Mrrvm/SCDTR/relatório.pdf

Controlo de Iluminaçao Distribu ˜ | ído

Sistemas de Controlo Distribuído em Tempo Real (MEEC) - Grupo 5 Carlos Aleluia, 81038 — Filipe Madeira, 81076 — Mariana Martins, 80856

Projeto disponível em https://github.com/Mrrvm/SCDTR
Link para vídeo de funcionamento do sistema presente no GitHub

10 de janeiro, 2018

Resumo—Dado um sistema de iluminaçao, o objetivo deste ˜
projeto e control ´ | a-lo distribuidamente de forma a maximizar o ´
conforto do utilizador e a minimizar a energia gasta. Propomos
a utilizaçao do algoritmo ˜ | | consensus aplicado a um sistema de
controlo, em que uma rede de agentes chega a um consenso da
soluçaõ otima, que gera a refer ´ | encia do sistema, ou determina ˆ
que nao existe uma soluç ˜ | ao vi ˜ | avel. Definimos como a rede dis- ´
tribuída de agentes aplica o algoritmo e construímos meios para testar a sua eficiencia. Obtivemos um sistema como pretendido ˆ inicialmente.
Palavras-Chave: Consensus, PID, servidor TCP/IP, I2C sniffing, Controlo distribuído.
I. INTRODUÇ AÕ
A ultima d ´ | ecada trouxe um nova forma de iluminaç ´ | ao: ˜
LEDs (Light Emitting Diodes). Comparativamente a l ` ampada ˆ incadescente convencional, o LED dura cerca de 50 vezes mais
horas e usa muito menos potencia [1]. A l ˆ | ampada fluorescente ˆ
foi um avanço relativamente a anterior, mas o LED continua a `
ter mais duraçao e efici ˜ | encia, e n ˆ | ao tem os perigos associados ˜
ao mercurio [2], apesar de ter perigos associados a outros ´
metais. Permite, tambem, uma integraç ´ | ao mais f ˜ | acil com ´
computadores e sensores. No entanto, esta tecnologia carece de optimizaçao em termos de energia e conforto do utilizador. ˜ De acordo com o tipo de ambiente, com a iluminaçao externa ˜
existente e com a ocupaçao, deveria ser poss ˜ | ível definir a
luminosidade, frequencia e c ˆ | or dos LEDs que comp ˆ | oem o ˜
sistema de iluminaçao. Para que isto seja faz ˜ | ível, este sistema
tem de ser definido como uma rede de agentes, em que cada agente tenta manter as características desejadas no seu LED, e podem comunicar entre si de modo a estabelecer o que e o ´ melhor para todos.
Esta rede tanto poderia ser distribuída como centralizada, naõ
obstante a versao distribu ˜ | ída apresenta alguns benefícios que
tornam a soluçao mais facilmente escal ˜ | avel. Ao p ´ | or o sistema ˆ
embebido mais perto do ponto de atuaçao, os tempos de ˜
resposta sao mais curtos, dado que um controlador central n ˜ | aõ
tem de lidar com operaçoes pequenas. N ˜ | aõ e necess ´ | ario fazer ´
ligaçoes com o n ˜ | o central, que teria uma procura cont ´ | ínua por
mais poder computacional, logo os custos de hardware saõ tambem mais baixos. ´
Este problema esta atualmente a ser investigado [3], [4], [5], e ´
que algumas soluçoes baseiam-se no uso do algoritmo ˜ | simplex,
que resolve problemas lineares e por si so n ´ aõ e distribu ´ | ído.
E neste contexto que propomos um sistema de controlo ´ distribuído de forma coordenada por uma rede de agentes baseado no algoritmo consensus [6], que e monitorizado com ´
estatísticas por clientes atraves de um servidor que as l ´ | e da ˆ
rede. Para testar a nossa soluçao, estabelecemos a configuraç ˜ | aõ
apresentada na proxima secç ´ | ao. Todo o c ˜ | odigo do projeto est ´ | á
disponível no repositorio de ´ | github indicado acima.

II. CONFIGURAÇ AO DO SISTEMA ˜

O modelo em causa pretende simular uma sala com duas lu-
minarias. Cada lumin ´ | aria tem um sensor, um microcontrolador ´
(arduino UNO) e um LED. Todos os elementos se encontram inseridos dentro de uma caixa como se pode observar na figura
1. A caixa foi forrada a branco de maneira a refletir mais a luz, assim como os arduinos. As ligaçoes foram feitas numa ˜
placa breadboard, que esta colada ao ch ´ | ao da caixa. Na caixa ˜
existe tambem um motor servo e uma janela. O servo pode ser ´ acionado por um dos arduinos, de maneira a abrir a janela. Por fora, a caixa incluí um Raspberry Pi 3B usado como servidor como se observa na figura 2.

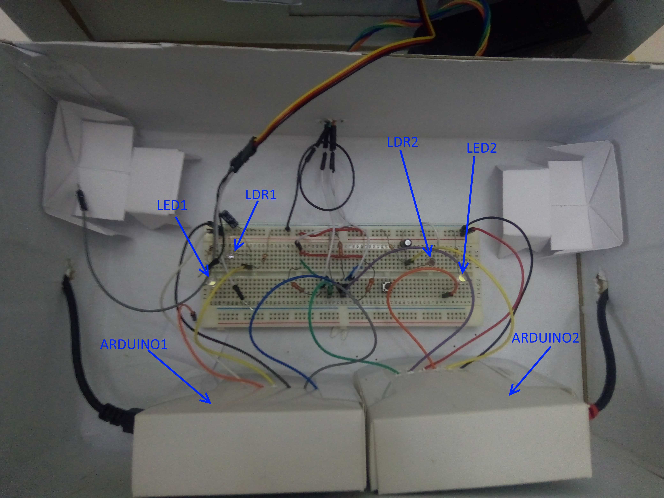
[picture p2: figure]

Figura 1: Caixa com luminarias. ´

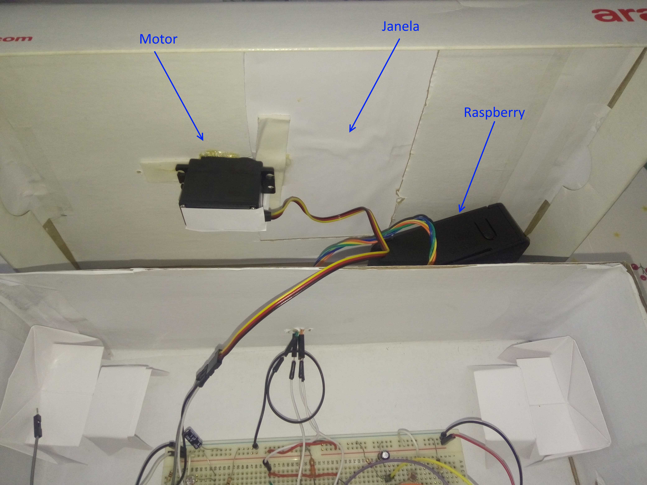
[picture p3: figure]

Figura 2: Motor, janela e raspberry.

III. ABORDAGEM

A. Calibraçao do LDR ˜
O sensor de luz utilizado e um LDR ( ´ | Light Dependent
Resistor). A resistencia diminui quanto maior for a intensidade ˆ de luz incidente. O sensor foi implementado de acordo com
a figura 3. Com mais outra resistencia ˆ | e poss ´ | ível obter um
divisor de tensao. Esta ˜ | e depois lida pelo o ardu ´ | íno e analisada.
A tensao lida ˜ | e dada pela express ´ | ao 1. O condensador permite ˜
a reduçao do ru ˜ | ído captado pelo sensor.

U = 5

R1
R1 + R2

(1)

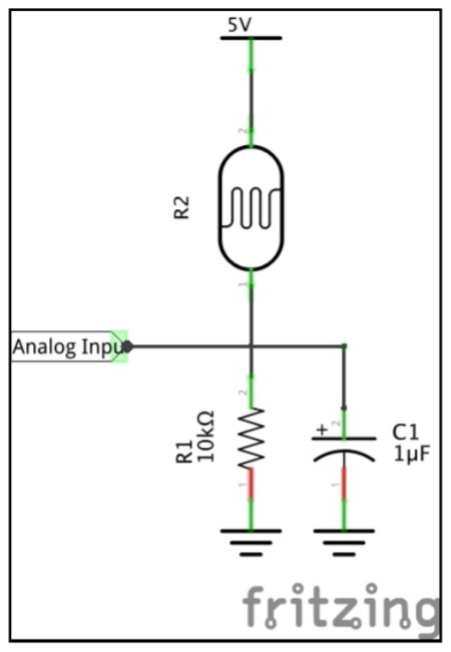
[picture p4: figure]

Figura 3: Circuito sensor de iluminaçao. ˜

E necess ´ | ario calibrar este sensor, pois existe uma gama de ´
possíveis valores, como se pode observar na figura 4, com os quais se pode definir uma reta que indica o valor da resistencia ˆ
em funçao da iluminaç ˜ | ao. Para descobrir os par ˜ | ametros da ˆ
reta foi usado um outro medidor de lux, onde se mediu a
iluminaçao e de seguida com base nas equaç ˜ | oes da matriz em ˜
baixo calculou-se os parametros A e B, sendo o declive e a ˆ ordenada na origem respetivamente.
| log10 ∗ R1 log10 ∗ R2
=
log10L1 | 1
log10L2 | 1

A
B

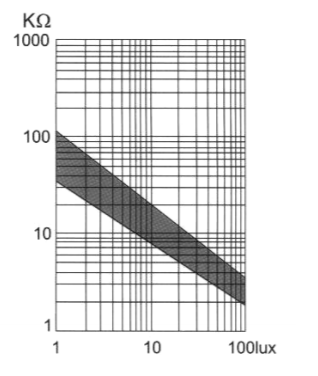
[picture p5: figure]

Figura 4: Resistencia em funç ˆ | ao iluminaç ˜ | ao. ˜
B. Identificaçao individual do sistema ˜
O sensor deteta a intensidade de lux atual e envia a
informaçao para o ardu ˜ | íno. De seguida o arduíno ajusta a
intensidade do LED de acordo com os requisitos impostos
ao sistema. O ajuste e feito atrav ´ | es de PWM ( ´ | Pulse Width
Modulation) e depende dos seguintes fatores:
- Luminosidade mínima com luminaria desocupada (25 ´ lux);
- Luminosidade mínima com luminaria ocupada (50 lux); ´
- Intensidade de luz vinda do exterior;
- Intensidade de luz proveniente de outros LEDs.

O PWM varia entre 0 e 255 o que e equivalente a 0V e ´
5V em tensao cont ˜ | ínua, mas e preciso saber a quantos lux ´
equivale cada valor de PWM. Sabendo que a intensidade de luz varia linearmente com o PWM, determinou-se o ganho (declive da reta) que define essa funçao. Na figura 5 pode-se ˜
observar os lux em funçao do PWM e constatar que a variaç ˜ | | aõ
e aproximadamente linear com um ganho de 0,3346. ´

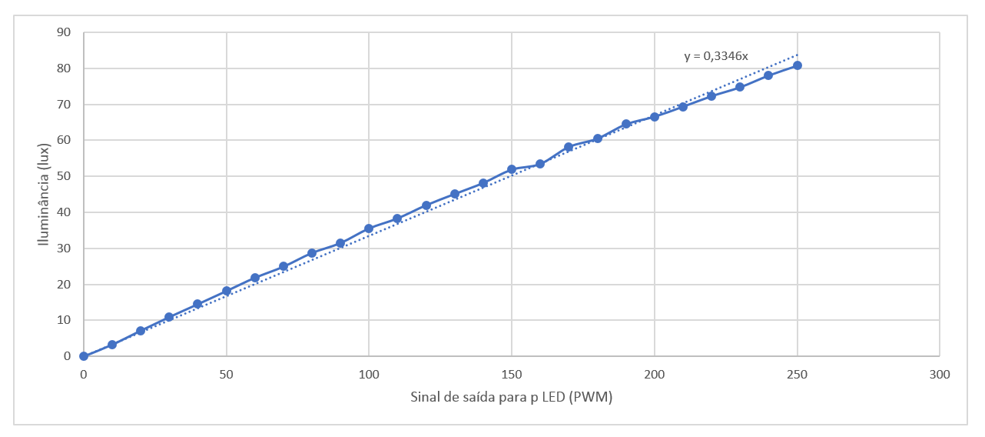
[picture p6: figure]

Figura 5: Lux em funçao do PWM. ˜

De modo a converter o valor de PWM para lux chegou-
se a equaç ` | ao final 2. O VDD ˜ | e igual ao valor de 5V, PWM ´
representa o valor que se quer converter e os parametros A e ˆ B representam a reta do LDR.

(

V DD
PWM
| | − 1) ∗ R1
| | 10B

1
A

(2)

O sistema de controlo implementado esta traduzindo na ´
figura 6, sendo que tanto o valor de referencia como o ˆ | feedback
sao controlados pelo ardu ˜ | íno. Estes topicos ser ´ | ao falados mais ˜
a frente. O ` | feedback e essencial, pois garante que a luz ´
proveniente do LED naõ e excessiva, diminuindo os consumos ´ de energia e tambem porque permite que o sistema se adapte a ´
uma nova situaçao de uma maneira mais confort ˜ | avel, ou seja, ´
com transiçoes menos bruscas. ˜

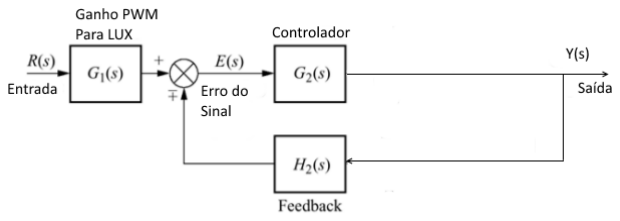
[picture p7: figure]

Figura 6: Esquema do controlador da luminaria. ´

Um ponto importante para o bom funcionamento do sistema
e a frequ ´ | encia de funcionamento, ou seja, a frequ ˆ | encia de ˆ
amostragem. O sistema tem que garantir a oscilaçao do LED ˜
naõ e detet ´ | avel pelo olho humano, logo tem de ser inferior a ´
40ms. No entanto nao faz sentido a frequ ˜ | encia ser o mais baixo ˆ
possível, pois implica um maior gasto de energia. Existe ainda um problema aderente ao condensador existente no circuito do sensor. O condensador requer um determinado tempo a carregar e portanto existe uma constante de tempo associada. De forma a medir esta constante foram retiradas amostras com o PWM a aumentar e obteve-se o grafico da figura 7. O PMW ´ foi aumentado apenas de meio em meio segundo de maneira
a que tensao lida tivesse tempo de ficar est ˜ | avel. ´

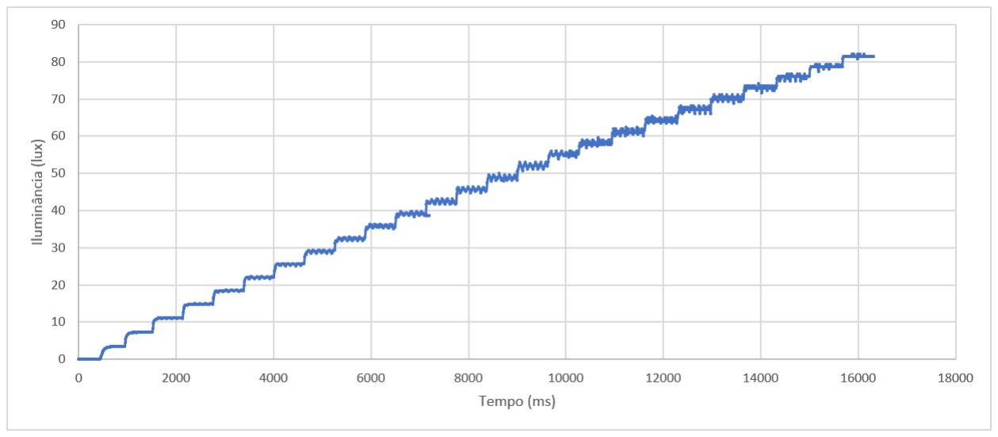
[picture p8: figure]

Figura 7: Lux em funçao do tempo. ˜

Como era de esperar o condensador demora mais tempo a carregar (a chegar um valor de tensao constante) quando ˜ o PWM se encontra inicialmente a 0. Isto porque nao s ˜ ó o condensador encontra-se completamente descarregado, mas
tambem porque a constante ´ | e dada pela formula 3 e esta ´
depende de R2, sendo que e maior quanto menor for a ´ intensidade de luz, como e o caso. ´
τ = R2C1 | (3)

Na figura 8 pode-se observar com mais pormenor a constante de tempo para o pior caso descrito em cima. A constante de tempo e determinada pelo o tempo que demora a atingir ´
√

1/2= 70% do valor em regime constante. Neste caso o valor obtido foi de 81ms. Este e um valor bastante alto, no entanto ´

e um caso particular, que s ´ | o acontece uma vez e n ´ | ao tem ˜
influencia no sistema. Verificou-se que para mudanças de va- ˆ lores típicos, como por exemplo de 25 lux para 50, a constante e de 8 ´ ms. Como tal optou-se por escolher uma frequencia de ˆ funcionamento tendo em conta a sensibilidade do olho humano e uma margem de segurança. O valor escolhido foi de 30ms.

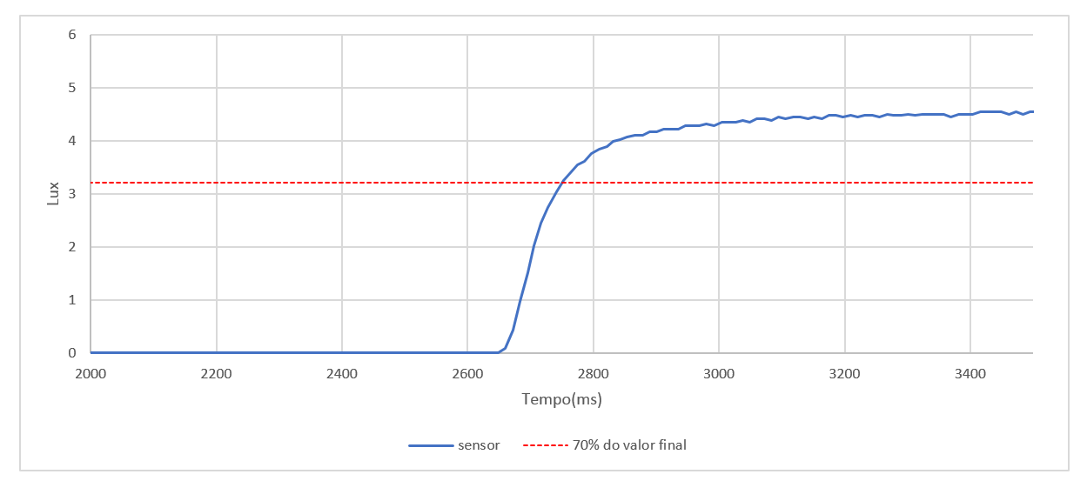
[picture p9: figure]

Figura 8: Lux em funçao do tempo para o pior caso. ˜

Com a constante de tempo e o ganho obtidos, o sistema individual em ciclo aberto e dado por ´

K0
1 + τ

C. Identificaçao do sistema com m ˜ | ultiplos ardu ´ | ínos
A rede de agentes e o aglomerado de v ´ | | arios sistemas ´
individuais descritos anteriormente, sendo que os ganhos relativos de cada um nao se alteram. No entanto, passam a ˜ existir ganhos entre eles, porque o LED de uma luminaria ´ pode ter influencia na intensidade de luz recebida por outra. ˆ
N luminarias implicam a exist ´ | encia de uma matriz de ganhos ˆ
com dimensao N x N, que neste caso ˜ | e de 2 x 2. ´
Y11

Y22
=
K11 | K12
K21 | K22 X11

X22

Na matriz Y e o valor de sa ´ | ída, K e o ganho de uma ´
luminaria em relaç ´ | ao a outra e X ˜ | e a luminosidade de uma ´
mesma luminaria. ´
D. Controlador
O controlador e respons ´ | avel por garantir que a intensidade ´
de luz numa dada luminaria se mant ´ | em dentro dos par ´ | ametros ˆ
estabelecidos. E constitu ´ | ído por 2 componentes: feedfoward
e feedback. Este ultimo tem uma componente proporcional ´ e uma componente integral. Cada arduino equivale a um
controlador local e a unica informaç ´ | ao que tem sobre os ˜
outros arduinos, caso existam, e o ganho de cada arduino ´ relativamente a si proprio, ou seja, a matriz discutida na ´ secçao III-C. ˜

Na figura 9 pode-se observar, mais detalhadamente o sistema de controlo. Todas as componentes irao ser explicadas ˜ de seguida. A componente derivativa foi retirada, pois nao s ˜ ó impedia que o PID funcionasse em tempo real, mas tambem´ porque para este caso, esta componente nao tem qualquer ˜ efeito.
Para minimizar o flickering, na mediçao do erro face ˜ | à
referencia do controlador implementou-se uma ˆ | dead zone, ou

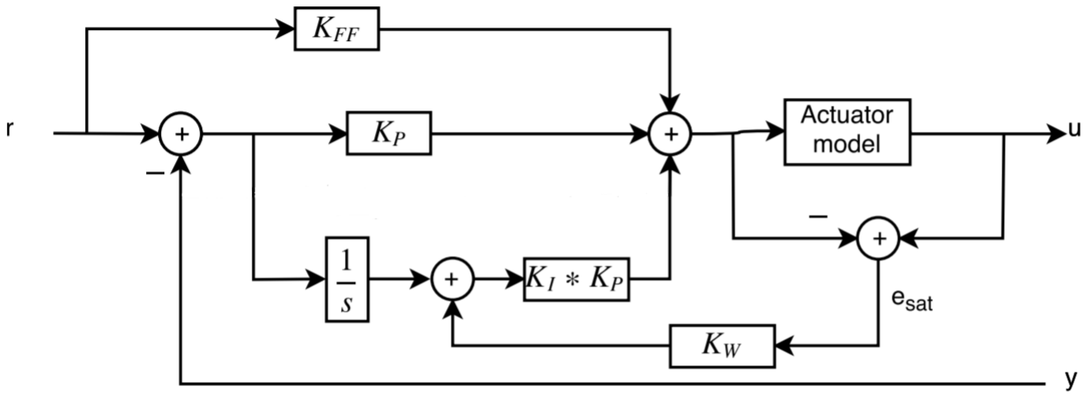
[picture p10: figure]

Figura 9: PID.

seja, o erro medido apenas era considerado caso fosse superior
a um patamar, em modulo. Uma representaç ´ | ao gr ˜ | afica da ´ | dead
zone implementada pode ser vista na figura 10, com parametro ˆ ERROR MAX=1.

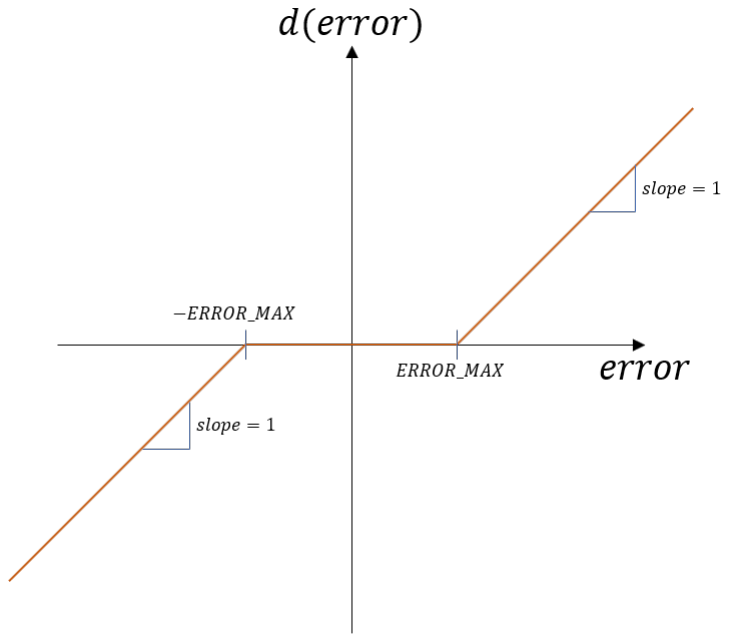
[picture p11: figure]

Figura 10: Deadzone implementada: erro fornecido ao PID
(d(error)) em funçao do erro medido ( ˜ | | error).
1) Feedfoward: Consiste em enviar um sinal de controlo do arduíno para o LED, de modo a acender o LED com uma certa intensidade de luz. Neste caso o controlo e feito com PWM. ´ O feedfoward permite ter uma melhor precisao, assim como ˜ uma melhor estabilidade do sistema e permite ainda atingir o
valor de referencia mais rapidamente. ˆ | E controlado atrav ´ | es da ´
constante KF F equivale ao ganho K medido anteriormente.
2) Feedback: Componente proporcional: Produz um sinal
de saída que e proporcional ´ | a amplitude do erro e(t), sendo `
Kp a constante de proporcionalidade. Este metodo possui a ´
vantagem de eliminar as oscilaçoes do sinal de sa ˜ | ída.
3) Feedback: Componente integral: Produz um sinal de
saída que e proporcional ´ | a magnitude e ` | a duraç ` | ao do erro, ˜
ou seja, ao erro acumulado. Isso fornece uma alternativa para corrigir o erro de offset gerado pela açao proporcional e ˜ acelera a resposta do sistema, permitindo-o chegar ao valor de referencia mais rapidamente. ˆ
Contudo, o termo integral tambem pode levar muitas vezes a ´ instabilidade ou a problemas de windup. O windup consiste
na acumulaçao de erros muito elevado (devido a saturaç ˜ | aõ
de actuadores, por exemplo), e caso ocorra leva a atrasos na resposta ou a overshooting. No caso deste projeto, se a
iluminaçao externa for maior do que a iluminaç ˜ | ao m ˜ | ínima

pretendida e caso esta seja a referencia dada ao PID, como ˆ
o sistema nao consegue retirar luminosidade (saturaç ˜ | ao dos ˜
atuadores), entao o termo integral vai acumular erros negativos ˜
durante um largo período. Se, nestas condiçoes, a iluminaç ˜ | aõ
externa voltar a diminuir, como o termo integral do feedback é
tao negativa o sistema vai permanecer apagado at ˜ | e descarregar ´
o erro acumulado. Um raciocínio semelhante podia ser feito para o caso inverso, levando a overshooting.
Portanto, implementou-se uma medida de anti-windup: em cada ciclo de controlo, se o termo integral for superior a uma
constante W ou inferior a −W, entao este ˜ | e saturado, ou seja, ´
o modulo do termo integral ´ | e sempre mantido no intervalo ´
[−W, W].
Existem diferentes formas de associar o feedforward e o feedback no sistema. Neste projeto, foi utilizada a tecnica de ´ decoupled feedforward, que consiste em utilizar o feedfoward para obter a resposta pretendida em condiçoes ideais e o ˜
feedback apenas ter interferencia para rejeitar perturbaç ˆ | oes ˜
ou nao idealidades do sistema. Para isso, ˜ | e necess ´ | ario um ´
conhecimento mais profundo e uma boa modelizaçao do sis- ˜
tema, pois consiste em fornecer como referencia ao ˆ | feedback
o comportamento esperado do sistema quando fornecido o feedforward.
No nosso caso, em boa aproximaçao (como ali ˜ | as foi visto ´
na secçao III-B), a resposta do sistema ao ˜ | feedforward pode
ser modelada por um escalao de amplitude correspondente ˜
a iluminaç ` | ao de refer ˜ | encia pretendida com um atraso de ˆ
um intervalo de sampling. Portanto, num primeiro ciclo de
controlo apos a alteraç ´ | ao de refer ˜ | encia (e, portanto, de valor ˆ
de feedforward) o termo de feedback fornecido ao sistema e nulo; nos ciclos seguintes, tudo se desenrola normalmente, ´
com referencia igual ao valor que se pretende que a lumin ˆ | aria ´
imponha atraves do LED. ´
E. Calibraçao do sistema ˜
Como foi referido na secçao III-C, numa rede de v ˜ | arios ´
arduinos existem efeitos de acoplamento, traduzidos em primeira ordem por ganhos Kij . Como qualquer alteraçao de ˜
iluminaçao externa ou de organizaç ˜ | | ao no interior da caixa ˜
usada implica mudanças nesses ganhos, era fundamental a
existencia de um m ˆ | etodo de calibraç ´ | ao em cada inicializaç ˜ | aõ
do sistema (ou reinicializaçao, mediante a ordem do cliente). ˜ Portanto, cada vez que o sistema e iniciado ou reiniciado, ´ todos os arduinos na rede iniciam um protocolo que permite cada um deles armazenar um array de ganhos relativos a todos os outros arduinos. Este protocolo consiste num ciclo em que, um arduino de cada vez, percorre todos os valores de duty
cycle (0-255) e todos os outros (incluindo o proprio que est ´ | á
a acender) medem a iluminaçao no seu LDR. Os ganhos s ˜ | aõ
entao calculados linearizando a curva: ˜

Kij =

li
dj
, | (4)
em que li e a iluminaç ´ | ao medida na lumin ˜ | aria ´ | i e dj o duty
cycle imposto na luminaria ´ | j. No final de serem percorridos
todos os valores de dj , toma-se como ganho a media dos ´ declives.

Para minimizar erros aleatorios, permitiu-se ainda definir ´
uma variavel ´ | C que indica o numero de amostras que ser ´ | aõ
retiradas (ou seja, cada arduino percorre todos os duty cycle de 0-255 C vezes).
O processo de troca de informaçao entre os arduinos (envio ˜ do duty cycle imposto de cada vez pelo arduino a acender
o LED) sera explicado mais detalhadamente na secç ´ | ao III-G, ˜
e todo o processo de calibraçao em termos de ˜ | software será
descrito na secçao III-H. ˜
F. Controlo Distribuído e Otimizaçaõ
Quando existem varios controladores em jogo, h ´ | a v ´ arias ´
topologias distintas de como organizar o controlo distribuído, mais concretamente, a capacidade de tomada de decisoes ou ˜ a forma como se comportam para atingir os seus objetivos. No caso específico deste projeto, a topologia utilizada foi de controlo distribuído descentralizado, pois nao existia nenhum ˜ controlador central que toma todas as decisoes globais, mas ˜ sim varios controladores capazes de comunicar entre si as suas ´ decisoes. ˜
Quanto a cooperaç ` | ao ou n ˜ | ao entre os diferentes n ˜ | os, ´ | é
possível o sistema funcionar das duas formas. Para agir de forma nao cooperativa, basta colocar os controladores indivi- ˜
duais a operar segundo a descriçao feita na secç ˜ | ao III-D1: cada ˜
arduino coloca o duty-cycle necessario para atingir a lumino- ´ sidade mínima estabelecida, ignorando a existencia do outro ˆ arduino. Nesta forma de atuar, cada agente apenas se preocupa
em cumprir o seu proprio objetivo, e trata qualquer aç ´ | ao de ˜
um outro agente como perturbaçoes externas e desconhecidas. ˜
Para funcionar de forma cooperativa, e necess ´ | ario um pro- ´
cedimento mais complicado, em que se procede a otimizaç ` | aõ
de uma funçao de custo tendo em conta todas as vari ˜ | | | aveis, ´
por exemplo, efeitos de coupling entre os dois controladores. Assim sendo, e fundamental que tenham um sistema de ´
coordenaçao e comunicaç ˜ | ao eficaz para que cheguem a um ˜
consenso acerca das variaveis que cada um tem que manipular, ´ a fim de atingirem a soluçaõ otima global. ´
Como foi referido nos objetivos do projeto, pretende-se minimizar o consumo de energia, maximizando o conforto de utilizadores (mantendo a iluminaçao acima de certos limites e ˜ reduzindo o flicker ao mínimo possível). Portanto, a funçao de ˜ custo que se pretende minimizar vai ter dois termos: um relacionado com o consumo de energia, ou seja, com dependencia ˆ linear nos duty cycle impressos pelos controladores; e outro
termo quadratico nos ´ | d, que representa um custo adicional
por desgaste da lampada, isto ˆ | e, ao penalizar soluç ´ | oes com ˜
duty cycle perto do maximo, aumenta a longevidade do LED. ´ Na verdade, o problema de otimizaçao pode ser formulado da ˜ seguinte forma:
minimize | c | T d + d T Qd
d1, ..., dN
subject to Kd + o ≥ L,
0 ≤ di ≤ 255, i = 1, ..., N.
| | | | (5)
Como e poss ´ | ível observar, a funçao de custo tem os dois ˜
termos mencionados, cuja influencia relativa ˆ | e determinada ´
pelos coeficientes ci (termo linear) e Qii (termo quadratico). ´
Nota-se que a matriz Q e diagonal pois n ´ | ao faz sentido ˜
a existencia de termos quadr ˆ | aticos cruzados. J ´ | a acerca das ´
restriçoes, a primeira garante que a iluminaç ˜ | ao imposta pelo ˜
conjunto de todos os arduinos (PN
j=1 Kijdj ), acrescentada à
iluminaçao externa existente ( ˜ | oi), e superior ao limite m ´ | ínimo
(Li). A segunda restriçao imp ˜ | oe os limites f ˜ | ísicos aos duty
cycle impostos. Imaginando o caso N = 2, uma forma facil de ´
entender as restriçoes relacionadas com a iluminaç ˜ | ao m ˜ | ínima
e escrev ´ | e-las na forma: ˆ | K11d1 + K12d2 ≥ L1 − o1 ↔ d2 ≥
L1−o1

K12

−

K11
K12
d1, e o mesmo para a restriçao de iluminaç ˜ | aõ
mínima no segundo controlador. Na figura 11 esta representada ´
a regiao delimitada pelas restriç ˜ | oes para o caso ˜ | N = 2. Uma
forma grafica de entender ao que corresponde o m ´ | ínimo que
se procura pode ser visualizada na figura 12.

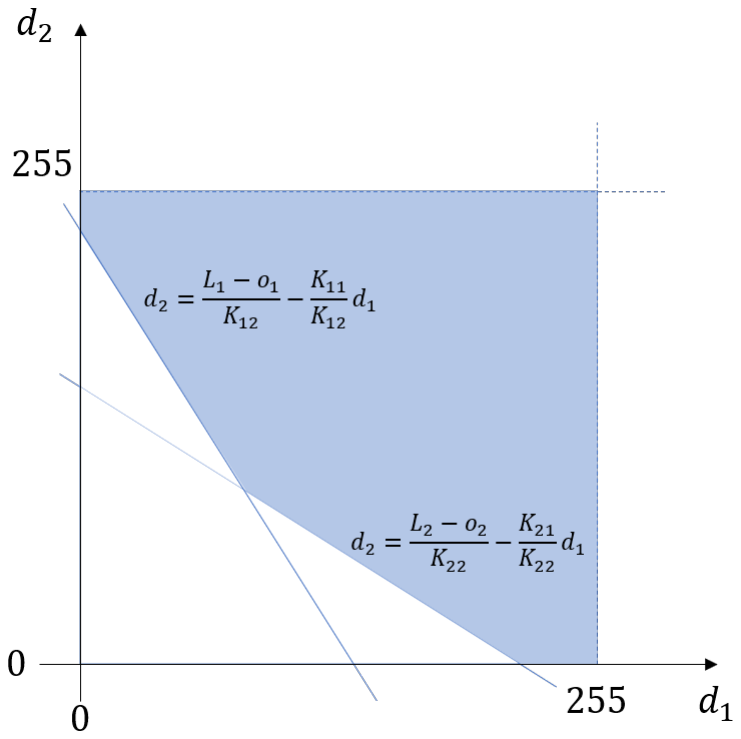
[picture p12: figure]

Figura 11: Representaçao, para o caso ˜ | N = 2, da regiao delimitada ˜
pelas restriçoes. ˜

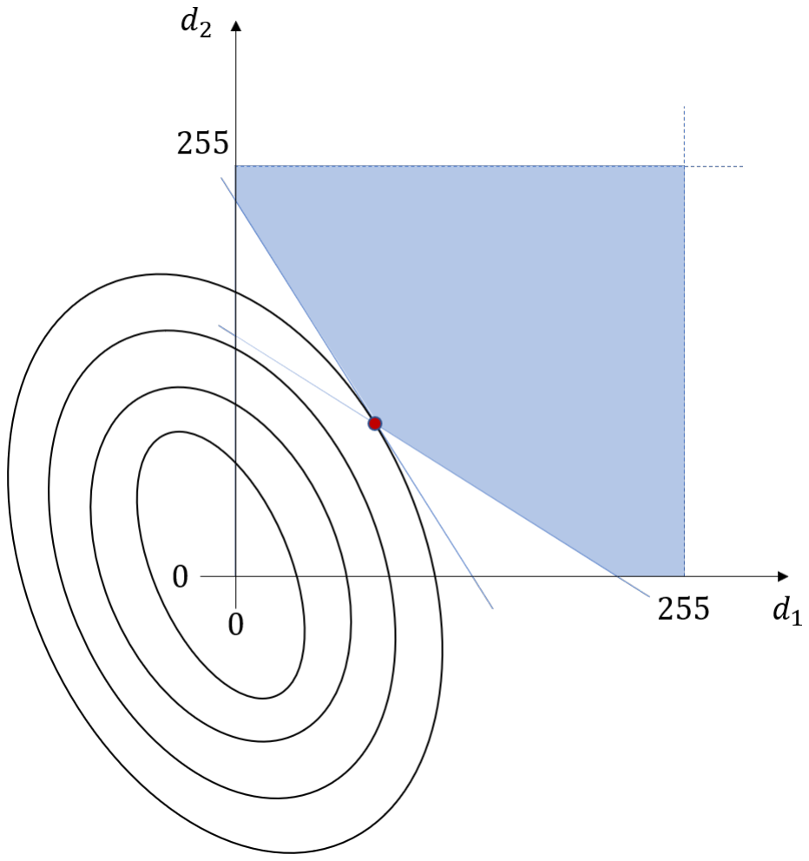
[picture p13: figure]

Figura 12: Representaçao, para o caso ˜ | N = 2, do mínimo da funçaõ
de custo, sujeita as restriç ` | oes. ˜

O problema descrito e um problema quadr ´ | atico, de ´
resoluçao f ˜ | acil caso o problema fosse resolvido por um pro- ´
cessador central com informaçoes de todos os n ˜ | os. Contudo, ´
como neste caso se pretende uma soluçao distribu ˜ | ída, cada
controlador deve calcular a sua variavel de controlo de forma a ´ minimizar a funçao de custo global, desconhecendo, na sua to- ˜ talidade, a informaçao dos outros controladores. Dependendo ˜
de algumas propriedades da funçao de custo e das restriç ˜ | oes, ˜
esta distribuiçao pode ser mesmo imposs ˜ | ível. No entanto, para
o problema em estudo, uma vez que a funçao a minimizar ˜ | é
totalmente separavel e as restriç ´ | oes podem ser parcialmente ˜
decompostas, isto e, o problema pode ser reescrito na forma: ´ minimize PN
i=1 f(di)
d1, ..., dN
subject to PN
i=1 h(di) ≤ 0,
di ∈ Ωi
, i = 1, ..., N,

(6)

existem metodos capazes de resolver problemas de otimizaç ´ | aõ
distribuídos como este. Neste projeto, foi utilizado o metodo ´ de alternating direction method of multipliers, ADMM, uma
ferramenta para resolver problemas de otimizaçao distribu ˜ | ídos
e que podem ser decompostos ate certo ponto, como o presente ´ [6]. Mais concretamente, vai ser aplicado a um problema de
otimizaçao de ˜ | consensus, isto e, onde existem vari ´ | aveis globais ´
- variaveis partilhadas por todos os n ´ | os - que devem refletir ´
as variaveis presentes em cada um dos controladores. No caso ´
apresentado, estas variaveis globais v ´ | ao ser os valores m ˜ | edios ´
de cada di entre todos os nos. Resumindo, o algoritmo vai ´
impor a restriç ˆ | ao de que, em cada controlador, as c ˜ | opias do ´
d sejam iguais ao valor medio que ´ | e partilhado por todos, ´
ou seja, que sejam iguais entre si! Desta forma, cada um
pode proceder a otimizaç ` | ao com restriç ˜ | oes, envolvendo os ˜ | duty
cycle dos outros, sabendo que todos possuem o mesmo valor. [7]
O metodo utilizado ´ | e, ent ´ | ao, um m ˜ | etodo iterativo, em que ´
a condiçaõ di − ¯di = 0, onde ¯di e a m ´ | edia sobre todos os ´
nos de ´ | di
, e satisfeita utilizando penalizaç ´ | oes de Lagrangiano ˜
aumentado, e em que cada iteraçaõ e atualizada a vari ´ | avel dual ´
(multiplicadores de Lagrange), de acordo com o dual ascent method [7]. Ou seja, em cada nó i sao feitas as seguintes ˜
operaçoes, na iteraç ˜ | aõ t:

di = arg min(
1/2 d

T
i Qdi + c

T
i di + y

T
i

(di − d¯i) + ρ
2

||(di − d¯i)||²
2

)
di ∈ χi
d¯i

t+1
=

1
N

PN
j=1 d

t+1
j
y

t+1
i = y

t
i + ρ(d

t+1

i − d¯i

t+1),
(7)
com yi sendo os multiplicadores de Lagrange e ρ o parametro ˆ de penalizaçao de Lagrangiano aumentado. Nota-se que os ˜
índices t nao foram colocados na primeira equaç ˜ | ao para ˜
nao sobrecarregar a notaç ˜ | ao, mas naturalmente ˜ | e calculado ´
o di utilizando os parametros da iterada anterior. Como a ˆ
otimizaçaõ e distribu ´ | ída, os parametros da funç ˆ | ao de custo ape- ˜
nas consideram o efeito do no atual, ou seja, ´ | c
| | T i = [0···ci
···0]
e Q = diag(0 · · · qi
- · · 0), e as restriçoes s ˜ | ao locais: ˜
χi = {di ∈ R | N : 0 ≤ dii ≤ 255 ,

X

N

j=1

Kijdij ≥ Li−oi}. (8)

Ja relativamente ´ | a resoluç ` | ao do problema com restriç ˜ | ao em ˜
cada no, mostra-se facilmente que se reduz a (refer ´ | encia!!): ˆ

d

t+1
i = argmin(
1/2 d

T
i Ridi − d

T
i

zi),
| | di ∈ χi

(9)

em que Ri = Qi + ρI e zi = −ci − yi + ρd¯
i. Portanto,
trata-se de um problema de otimizaçao convexo. A soluç ˜ | aõ
pode estar no interior da regiao permitida pelas restriç ˜ | oes ou ˜
pode estar na sua fronteira, como pode ser visto na figura 13 para o caso N = 2. Nota-se que nesta imagem ja se aplicou o ´
facto de apenas condicionarem a soluçao as restriç ˜ | oes locais. ˜
Para verificar se o mínimo esta no interior, calcula-se ´ quando o gradiente da funçao de custo anterior se anula, ou ˜ seja,
d

∗

i = R⁻¹
i
zi, | (10)

e testam-se as restriçoes. ˜

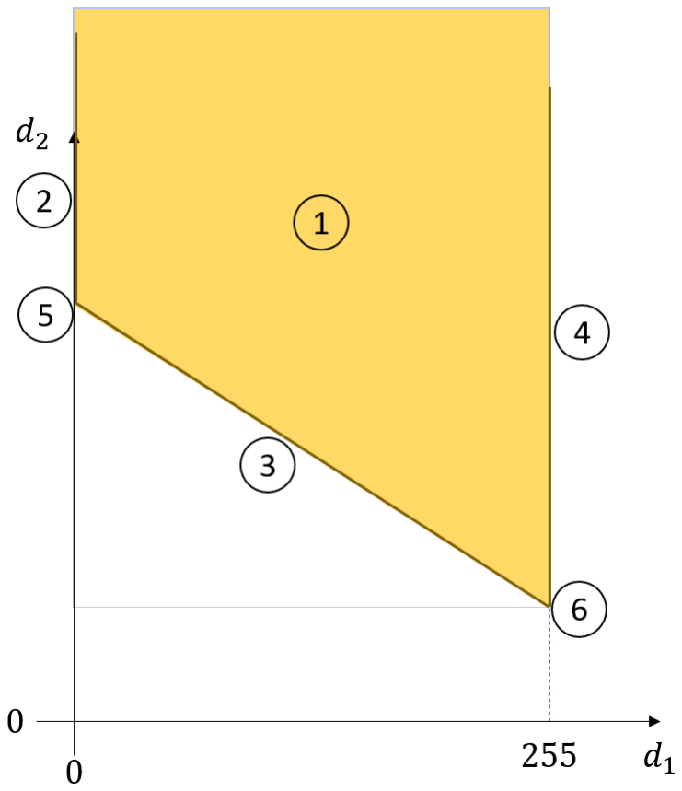
[picture p14: figure]

Figura 13: Representaçao, para o caso ˜ | | N = 2, dos diferentes tipos
de soluçoes poss ˜ | íveis: no interior do conjunto, nas fronteiras e nas
suas interseçoes. ˜

Caso a soluçao esteja na fronteira, pode estar na fronteira de ˜
qualquer uma das 3 restriçoes ou na interseç ˜ | ao de quaisquer ˜
pares possíveis (ver figura 13). Se as fronteiras l possíveis estiverem escritas na forma

A

(l)
| i di = u

(l)
i
, | (11)
entao prova-se [6] que a soluç ˜ | ao nessa fronteira ˜ | e dada por: ´

d

∗

i = R⁻¹
i

zi + R⁻¹
i AT
i

(AiR⁻¹
i AT
i

)

−1

(ui − AiR⁻¹
i

zi).
(12)
A título de exemplo, para a soluçaõ 4 representada na figura
13 (ou seja, restringida a fronteira representada por ` | d1 = 255),
A

(4)
i = [1 0] e u

(4)
i = 255.
Numericamente, em cada iteraçao, calculam-se as 6 ˜
soluçoes poss ˜ | íveis, testa-se a sua viabilidade recorrendo as`
restriçoes e escolhe-se a que estiver associada a um valor ˜
da funçao de custo menor (utilizando a express ˜ | ao completa, ˜

presente na equaçao 7). Em termos de c ˜ | odigo, foi utilizada ´
uma biblioteca que definia produtos matriciais e vetoriais, de
forma a que o calculo das soluç ´ | oes fosse totalmente gen ˜ | erico ´
e escalavel, apenas fazendo os produtos presentes em 10 e 12. ´ A biblioteca utilizada foi a MatrixMath [8].
No final de cada iteraçao, os n ˜ | os procedem ´ | a troca dos ` | di
calculados por cada um, de forma a que calculem a media ´ | d¯
i
e seja igual em todos. Este processo de troca de informaçaõ
tambem´ | e totalmente gen ´ | erico e escal ´ | avel, e ser ´ | a melhor ´
descrito na secçao III-G. ˜
No final, quando o algoritmo convergir (ou seja, quando
todos os nos tiverem a mesma soluç ´ | ao final), o termo de ˜
feedforward que cada arduino passa a colocar e o seu ´ | duty
cycle respetivo da soluçao final. Al ˜ | em disso, a refer ´ | encia que ˆ
os termos de feedback passam a seguir tambem´ | e alterada, ´
por duas razoes. Em primeiro lugar, podia acontecer que, ˜
devido a custos assimetricos, a soluç ´ | aõ otima implicasse um ´
deles colocar mais intensidade do que seria necessario caso ´ estivesse isolado, para auxiliar os outros. Nessas condiçoes, o ˜
feedback ia tentar baixar a iluminaçao medida para o m ˜ | ínimo
pois apenas tenta manter a referencia. Em segundo lugar, ˆ caso existisse iluminaçao externa mais do que suficiente para ˜ garantir o mínimo, o feedback tambem podia deixar de tentar ´
baixar o seu valor até a refer ` | encia antiga. Resumindo, a ˆ
expressao que foi utilizada para determinar a nova refer ˜ | encia ˆ
foi a seguinte:

L

0
| | i = max{Li
,

X

N

j=1

Kijdij + oi}, | (13)

em que L

0
i
e a nova refer ´ | encia. O facto de se utilizar o m ˆ | aximo ´
e s ´ o para garantir que, se por algum tipo de imprecis ´ | aõ
numerica o segundo termo for ligeiramente inferior ao m ´ | ínimo
permitido nessa luminaria, ´ | Li
, entao a refer ˜ | encia para o ˆ
feedback faz subir a iluminaçao do que faltar at ˜ | é Li
| | , em vez
de se contentar com iluminaçao um pouco abaixo do m ˜ | ínimo.
G. Comunicaçao I2C ˜
| A comunicaçao entre os arduinos e a recolha de informaç ˜ | | aõ
pelo Raspberry Pi foi feita utilizando o protocolo de
comunicaçao s ˜ | erie s ´ | íncrono Inter-Integrated Circuit, normal-
mente designado apenas por I2C. Este protocolo permite naõ
so comunicaç ´ | ao entre v ˜ | arios ´ | masters (quem controla as linhas
de comunicaçao) e v ˜ | arios ´ | slaves (para quem a mensagem do
master e endereçada), mas tamb ´ | em permite comunicaç ´ | ao entre ˜
um numero muito elevado de dispositivos utilizando apenas 2 ´ fios: clock line (SCL) e data line (SDA).
Segundo este protocolo, os dispositivos nas linhas devem
estar associados a um endereço de 7 bits. As comunicaçoes s ˜ | aõ
iniciadas pela condiçao de ˜ | START e terminadas pela condiçaõ
de STOP, impostas as linhas SCL e SDA pelo dispositivo a ` atuar como master. Cada conjunto de informaçaõ e composta ´
por 8 bits (1 byte), tendo o master, apos a condiç ´ | ao de ˜ | START,
ter que comunicar os 7 bits de endereço do slave a quem se
dirige, alem do bit final, que indica se pretende fazer ´ | | | write ou
read do slave [9].

Cada arduino permite a comunicaçao por I2C nestes dois ˜ modos de funcionamento, ou seja, em write ou read, como referido atras: ´

- MT/SR - Master Trasmitter, Slave Receiver: o dispositivo a operar como master envia dados para o dispositivo a servir de slave, que apenas recebe;
- MR/ST - Master Receiver, Slave Trasmitter: o dispositivo a operar como master solicita dados do slave, que responde.
Neste projeto apenas foi utilizado o primeiro modo de funcionamento descrito (MT/SR) pois e o mais simples e menos ´ suscetível de provocar erros. A biblioteca Wire do Arduino permitiu facilitar a implementaçao do protocolo, apenas tendo ˜ o dispositivo master que iniciar a transmissao, especificando ˜ o endereço do slave a quem se pretendia dirigir.
No ambito do projeto, todas as comunicaç ˆ | oes por I2C ˜
foram feitas em modo broadcast, ou seja, enviadas para todos os dispositivos, que nao o ˜ master, receberem. Isto foi implementado dirigindo as transmissoes para o endereço ˜ ”0”. De qualquer forma, para cada arduino poder participar
nas comunicaçoes, foi necess ˜ | ario atribuir um endereço a ´
todos. Para isso, escreveu-se na EEPROM um inteiro que foi interpretado como o seu endereço de comunicaçao. Este ˜
numero tamb ´ | em foi utilizado para outras aplicaç ´ | oes, sempre ˜
que era necessario tomar aç ´ | oes diferentes consoante o ˜ | índice
do arduino (por exemplo, na calibraçao e no algoritmo de ˜
controlo distribuído). Relativamente a frequ ` | encia da linha ˆ
SCL, utilizou-se a predefinida, ou seja, 100kHz. Contudo, testou-se ate 400kHz e o sistema continuava a funcionar ´ corretamente.
Em todas as comunicaçoes iniciadas pelos arduinos, antes ˜ de se enviarem os dados propriamente ditos, e sempre enviada ´ uma label (um caracter ASCII) para facilitar o processo de
interpretaçao dos dados enviados n ˜ | ao s ˜ | o pelos restantes ardui- ´
nos, como tambem pelo Raspberry Pi na tarefa de recolher ´ dados do sistema. De seguida encontram-se detalhadas todas as comunicaçoes empregues por I2C no sistema: ˜
- Calibraçaõ , Label: ”k”: enviada por um arduino en-
quanto estao todos a efetuar a calibraç ˜ | ao. O arduino que ˜
esta a acender o LED envia o ´ | duty cycle, de 0 a 255, que
esta a colocar no LED para os outros calcularem o ganho ´ cruzado.
- Consensus, Label: ”c”: enviada por um arduino enquanto
estao todos no algoritmo de otimizaç ˜ | ao distribu ˜ | ído. Um
arduino, de cada vez, envia 2 inteiros: um para identificar qual o índice do d enviado (na verdade, trata-se do índice-1, para facilitar) e outro para enviar o valor em si. Por exemplo, se a soluçaõ otima calculada, pelo arduino 2 ´
para o arduino 1 (1-1=0), for d1 = 100, entao a sequ ˜ | encia ˆ
sera ”c”,”0”,”100”. ´
- Restart, Label: ”r”: enviada por um arduino quando recebe um comando, via Serial do Raspberry Pi, a indicar para recomeçar o sistema e recalibrar. Os arduinos que receberem essa label ficam com uma flag ”calibrated”=0,
portanto a proxima vez que iniciarem o ´ | loop entram na
calibraçao, todos coordenados. ˜
- Recalibraçaõ , Label: ”b”: enviada por um arduino

quando e reiniciado. Esta comunicaç ´ | aõ e necess ´ | aria por- ´
que, por exemplo, ao ligar a Serial do Raspberry Pi, o arduino que lhe estiver ligado faz automaticamente reset, ou seja, precisa de voltar a fazer a calibraçao. Uma vez ˜ que a calibraçao apenas funciona se todos estiverem a ˜
realiza-la simultaneamente, ent ´ | aõ e necess ´ | ario enviar esta ´
informaçao para que os restantes arduinos na rede voltem ˜
a etapa de calibraç ` | ao e se mantenham todos coordenados. ˜
- Set, Label: ”s”: enviada por um arduino quando recebe um comando, via Serial do Raspberry Pi, a indicar alterar
a ocupaçao de um arduino qualquer do sistema. Ap ˜ | os´
a label, envia exatamente o inteiro que recebeu por
Serial, que sera interpretado pelo arduino alvo, atrav ´ | es´
da codificaçao: ˜ | (address − 1) ∗ 2 + 1 → ocupaçao=0 ; ˜
(address − 1) ∗ 2 + 2 → ocupaçao=1. Esta codificaç ˜ | aõ
permite minimizar a informaçao enviada e maximizar o ˜ numero de arduinos na rede a quem esta mensagem pode ´ chegar. A título de exemplo, caso se pretenda colocar a ocupaçao do arduino 2 a 1, o inteiro enviado por ˜ Serial e retransmitido por I2C para a rede inteira é (2 − 1) ∗ 2 + 2 = 4.
- Refazer o consensus, Label: ”z”: enviada por um arduino se receber, por meio da comunicaçao anterior, ordens ˜
para alterar a ocupaçao e, portanto, a sua iluminaç ˜ | aõ
mínima. Quando os restantes arduinos recebem esta label realizam todos o algoritmo de controlo distribuído de forma coordenada.
- Ligar/Desligar controlo distribuído, Label: ”p”: enviada por um arduino quando recebe um comando, via Serial do Raspberry Pi, a indicar alterar o estado do controlo distribuído. Se receber uma instruçao para desligar o ˜
algoritmo de controlo distribuído, entao envia, al ˜ | em da ´
label, um ”0”; caso seja para o ligar, envia um ”1”.
- Informaçao para o Raspberry Pi ler ˜ | | , Label:
”a”: enviada por todos os arduinos apos cada ci- ´ clo de controlo, caso sejam efetuados calculos. ´ Esta mensagem e totalmente ignorada pelos ardui- ´ nos, e apenas enviada para fins de coletar os da- ´ dos pelo Raspberry Pi. Cada arduino envia os dados seguindo a forma: ”a”,<endereço>,”l”,<iluminaçaõ medida>,”d”,<duty cycle>,”o”,<ocupaçaõ >. Nota-se que o tempo que cada arduino demora a enviar esta
mensagem e ligeiramente inferior a ´ | 1ms, pelo que caso
a rede crescesse acima de 25 nos, alguma alteraç ´ | ao teria ˜
que ser feita (retirar os caracteres auxiliares ou aumentar
a frequencia do ˆ | SCL, por exemplo).
- Referencia e iluminaç ˆ | ao externa para o Raspberry ˜
Pi ler, Label: ”i”: enviada por todos os arduinos apos´
terem efetuado a calibraçao e o controlo distribu ˜ | | ído. Esta
mensagem e totalmente ignorada pelos arduinos, ´ | | e apenas ´
enviada para fins de coletar os dados pelo Raspberry Pi. Cada arduino envia os dados seguindo a forma: ”i”,<endereço>,”t”,<referencia ˆ >,”x”,<iluminaçaõ externa>.
H. Arquitetura do software do Arduino
O funcionamento do programa nos arduínos esta represen- ´ tado na 14. Ao reinicializar o sistema ”r”, mudar a abertura

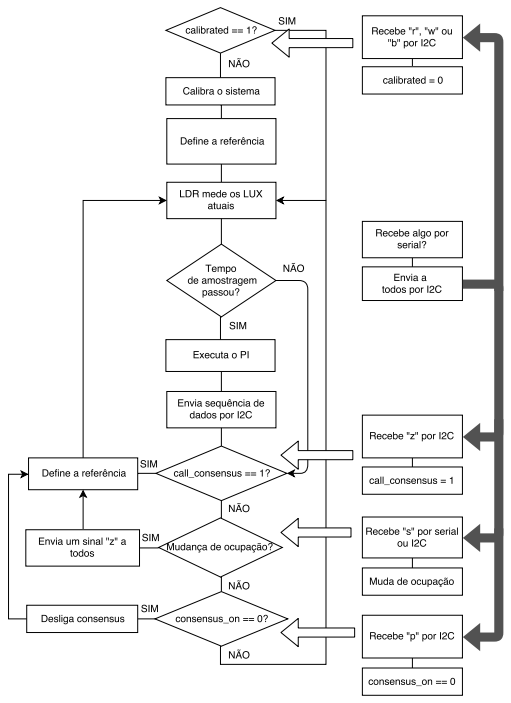
[picture p15: figure]

Figura 14: Fluxograma principal

da janela ”w”, fazer reset a um dos arduínos ”b”ou sim-
plesmente iniciar o sistema, e feita a calibraç ´ | ao represen- ˜
tada na figura 15. O codigo respetivo ´ | a mesma est ` | a con- ´
tido nas funçoes ˜ | loop calib() e calib() em arduino/main/Ar-
duino final.ino. Começa por medir a iluminaçao externa na ˜ caixa, de acordo com o no de amostras definido, para a poder
descontar mais tarde a luminosidade lida do LDR. A vari ` | avel ´
step representa o endereço da lumiaria que est ´ | a a calibrar, isto ´
e, que est ´ | a a iterar o ´ | duty-cycle do LED de 0 a 255, e que a
cada iteraçao envia esse valor para todas as outras lumin ˜ | arias e ´
obtem o valor dessa luminosidade medido no seu pr ´ | oprio LDR. ´
Este processo e repetido consoante o n ´

o de amostras, quando
estiver completo aumenta o step para representar a calibraçaõ
da proxima lumin ´ | aria. Enquanto isto, as outras lumin ´ | arias ´
foram recebendo valores de duty-cycle da que estava a calibrar, leram esses valores nos seus LDRs e calcularam o ganho relativo a essa luminaria com todas as amostras, como foi ´ explicado na secçao III-E. No final, guardaram o ganho e ˜
incrementaram o step, pelo que agora a proxima lumin ´ | aria ´
a calibrar e a que tiver o endereço correspondente ao mesmo. ´
Para se definir o que e o final, foi criada uma vari ´ | avel ´ | count
que conta o no de mediçoes feitas. No entanto, como os ˜ arduínos podem estar desfasados, o minímo a partir do qual se considera o fim naõ e exatamente 255 vezes o n ´

o de
amostras, mas sim o valor definido experimentalmente perto disso. Adicionalmente, todas as luminarias verificam se o ´
arduino da que esta a calibrar morreu atrav ´ | es do tempo que ´
esta a demorar, em caso positivo assumem que o ganho relativo ´ e zero. ´
Voltando ao programa principal (figura 14), feita a calibraçao, ˜
e definida a refer ´ | encia do sistema. Todas as funç ˆ | oes relaci- ˜

onadas com o sistema de controlo estao organizadas numa ˜
classe (PID) que esta definida em ´ | arduino/main/PID.h e
arduino/main/PID.cpp. Para este caso e utilizada a funç ´ | aõ
PID::SetReference(), que define a referencia como o resultado ˆ do consensus caso este esteja ligado ou caso nao esteja, ˜ como o valor definido de ”HIGH” ou ”LOW” de acordo
com a ocupaçao. Seguidamente, o LDR da lumin ˜ | aria mede ´
os lux atuais na caixa, e caso tenha passado o tempo de amostragem fixado (25 ms), executa os calculos de controlo PI ´
e envia a sequencia de carateres indicada na III-G necess ˆ | aria ´
ao Rapsberry Pi.
A seguir, se a variavel ´ | call consensus estiver a 1, a referencia ˆ
e definida novamente. Esta vari ´ | avel est ´ | a sempre a 0, a n ´ | aõ
ser que o arduíno receba por o I2C a label ”z”, que está explicada na secçao anterior. Se houver uma mudança de ˜
ocupaçao das lumin ˜ | arias, ´ | e como dito, enviada essa ´ | label
a todos os arduínos atraves da funç ´ | aõ | PID::SetOccupancy
e definida no proprio ardu ´ | íno uma nova referencia. Se o ˆ
sistema de controlo distribuído for desligado, e determinada ´ mais uma vez a referencia agora sem o mesmo. Repete-se o ˆ todo processo, novamente.
Quando o arduíno que esta ligado por ´ | serial ao Raspberry
Pi, recebe algum carater, a mensagem e enviada a todos os ´ arduínos por I2C, e sao estas mensagens que definem valores ˜ para variaveis capazes de alterar o funcionamento do sistema ´ com base na interaçao do cliente. ˜
O sistema de controlo distribuído esta definido como um ´
metodo da classe, nomeadamente ´ | PID::Consensus(). As
operaçoes de matrizes est ˜ | ao definidas ˜ | a parte nos fi- `
cheiros arduino/main/MatrixMath.cpp e arduino/main/Ma-
trixMath.h, que foram obtidos no repositorio de ´ | github
https://github.com/eecharlie/MatrixMath.
I. Arquitetura do software do Raspberry Pi

O software implementado no Raspberry Pi e composto por ´ 3 partes principais representadas na figura 16. O processo da
direita faz sniffing da comunicaçao I2C entre os ardu ˜ | ínos,
analisa a informaçao e escreve a que ˜ | e relevante para um ´
FIFO. O processo da esquerda esta dividido em duas threads. ´
Uma delas le a informaç ˆ | ao do FIFO e guarda-a numa estrutura ˜
partilhada. A outra recebe ligaçoes de clientes, e cria uma ˜ sessao para cada um. ˜
- A thread que aceita ligaçoes de clientes ˜ | foi
implementada usando a biblioteca de C++ BOOST
[10], que permite a abstraçao de toda a criaç ˜ | ao de ˜
sessoes por cliente aceite quando usada assincronamente. ˜ O servidor e assim capaz de lidar com pedidos de ´
varios clientes paralelos (cada um usando o seu ´ | socket)
e emitir as respostas respetivas para cada um. Para este fim, foram implementadas 2 classes (tcp server e conn contidas em raspberry/main/server.cpp). A primeira
e respons ´ | avel por aceitar as ligaç ´ | oes, a segunda, que ˜
representa a sessao do cliente, ˜ | e respons ´ | avel por receber ´
pedidos e responder-lhes adequadamente. Estes ultimos ´ tanto podem ser pedidos de interaçao com o sistema, ˜ sets, ou pedidos para obter estatísticas, gets.

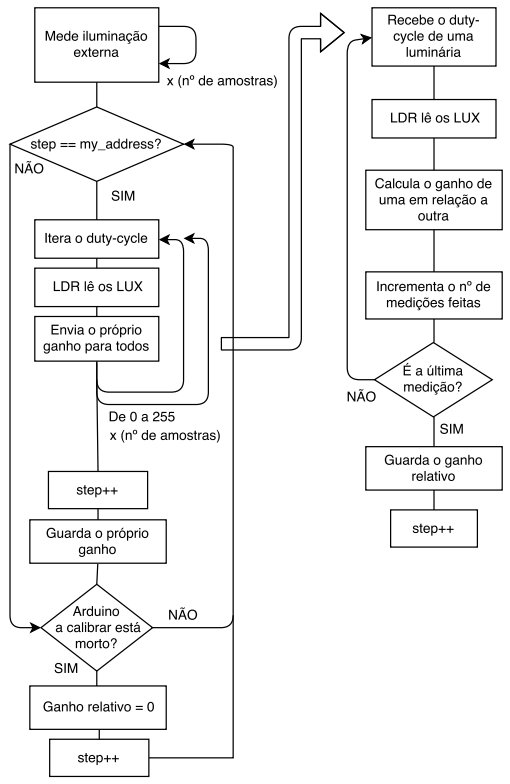
[picture p16: figure]

Figura 15: Fluxograma da calibraçaõ

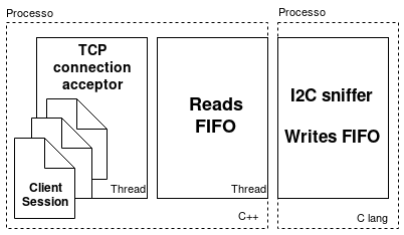
[picture p17: figure]

Figura 16: Arquitetura do software do Raspberry Pi

No primeiro caso, o servidor manda via serial (USART convertido para/de USB) um inteiro para um do arduínos que o comunica aos outros como explicado na III-G, e manda para o cliente um acknowledgement como prova que o pedido foi enviado ao sistema. O servidor permite que o cliente faça uma reinicializaçao ao sistema, defina ˜
a ocupaçao de cada lumin ˜ | aria, defina se o ´ | consensus
esta a ser aplicado ou n ´ | ao, e defina o ˜ | angulo de abertura ˆ
da janela.
Quando o cliente quer obter estatísticas do sistema, estas sao retiradas da estrutura de dados partilhada que ˜
tem guardada essa informaçao desde a inicializaç ˜ | aõ
e adequadamente enviadas de acordo com o pedido. As respostas do servidor estao implementadas em ˜ raspberry/main/resolve get.cpp). De forma, a responder ao pedido de streaming a tempo real, foi implementado um temporizador que verifica de 5 em 5 segundos se há informaçao que deve ser enviada e caso seja esse o caso ˜ envia-a. O streaming pode ser composto pelo duty-cycle, pela luminosidade ou por ambos de arduínos diferentes ao mesmo tempo.
- A outra thread esta assincronamente a ´ | ler nova
informaçao do FIFO ˜ | (usando a biblioteca citada
acima) e a guarda-la no seu lugar respetivo na estrutura ´ de dados. Esta informaçao aparece na forma de um ˜ string, que pode ser uma sequencia de dados sobre ˆ
uma luminaria, por exemplo a1l100d50o1 (lumin ´ | aria ´
1 tem luminosidade 100, duty-cycle 50 e ocupaçao 1) ˜ ou uma sequencia recebida apenas uma vez no fim ˆ da calibraçao/ ˜ consensus, i1t50x40 (luminaria 1 tem ´
referencia 50 e iluminaç ˆ | ao externa 40). O ˜ | timestamp da
sequencia ˆ | e originado quando esta ´ | e lida do FIFO. Esta ´
parte esta implementada numa classe ( ´ | sniff) contida em
raspberry/mainserver.cpp.
- O processo que faz sniffing foi implementado em C usando o codigo ´ I2C Sniffer presente nos exemplos da biblioteca pigpio [11]. Uma vez que este programa corre a uma frequencia mais alta que a do I2C ˆ
(100kHz), e necess ´ | ario determinar se o byte que ´
esta a ser recebido ainda ´ | e o mesmo ou n ´ | ao. J ˜ | a que ´
pode haver a possibilidade de bytes correspondentes a dados diferentes terem o mesmo valor, os arduínos enviam carateres antes de cada valor para a garantir
que nao se perde informaç ˜ | ao. Assim, a cada sequ ˜ | | encia ˆ
de dados detetada (relativa a lumin ` | aria ou ao fim da ´
calibraçao/ ˜ consensus), e escrita a mesma para o FIFO ´
em formato string. O codigo implementado est ´ | a contido ´
em raspberry/main/I2Csniff.c
A estrutura de dados e um ´ | vector de objectos da
classe Data (contida em raspberry/main/data.h) em que cada objecto representa uma luminaria e ´ e composto por 5 ´ vetores principais (tempo, luminosidade, duty-cycle, ocupaçaõ
e energria) e outras variaveis que ajudam nos c ´ | alculos a ´
serem feitos. A energia instantanea ˆ | e calculada assim que ´
nova informaçao chega ao vetor, de forma a diminuir o ˜
tempo de computaçao em futuros c ˜ | alculos. Dado que a ´
estrutura e partilhada entre threads, est ´ | a protegida por um ´
mutex. A implementaçao pode ser consultada nos ficheiros ˜ raspberry/main/data.cpp.

IV. EXPERIENCIAS ˆ

De forma a analisar qualitativamente os varios aspetos do ´ sistema, foram realizadas diversas experiencias, cada uma ˆ para testar e validar os conceitos descritos na Abordagem.
As experiencias realizadas e as suas configuraç ˆ | oes foram as ˜
seguintes:
- Abertura da janela e mudança de referencia ˆ . A primeira experiencia realizada foi somente observar o ˆ funcionamento do sistema em duas condiçoes usuais: ˜ abertura da janela passados a meio do controlo do sistema, de forma a observar a resposta do sistema a esta
perturbaçao externa; e alteraç ˜ | ao da ocupaç ˜ | ao de uma das ˜
luminarias (portanto, alterando a sua refer ´ | | encia). Foram ˆ
feitas mediçoes da iluminaç ˜ | ao, em lux, e do ˜ | duty cycle,
ambos em funçao do tempo para um dos n ˜ | | os, com ambos ´
ligados. A analise e discuss ´ | ao dos resultados est ˜ | a presente ´
na secçao V-A. ˜
- Energia gasta pelas luminarias ´ | . Mediu-se, ao longo do
tempo, a primeira metrica de avaliaç ´ | ao de desempenho ˜
do sistema: a energia gasta em cada no. A energia das ´
luminarias foi obtida calculando a pot ´ | encia instant ˆ | anea e ˆ
somando ao longo do tempo (supondo que 1 LED gasta, no maximo, 1 W de energia): ´

E =

X

N

i=2

di−1(ti − ti−1). | (14)
Obtiveram-se entao os gr ˜ | aficos de energia em funç ´ | ao do ˜
tempo para ambas as luminarias, presentes na secç ´ | ao V-B. ˜
- Erro de conforto. De seguida, mediu-se a segunda
metrica de avaliaç ´ | ao: o erro de conforto. Esta m ˜ | etrica ´
permite quantificar a capacidade do sistema evitar descer abaixo do mínimo de iluminaçao, calculada usando a ˜ seguinte a expressao: ˜

Cerror =

1
N

X

N

i=1

max(lref erencia(ti) − lmedido(ti), 0).

(15)
A evoluçao desta m ˜ | etrica de avaliaç ´ | ao est ˜ | a na secç ´ | ao V-C. ˜
- Variancia de conforto ˆ | . Por ultimo, mediu-se a terceira ´
metrica de avaliaç ´ | ao: a vari ˜ | ancia de conforto (para quan- ˆ
tificar o flickering), calculada seguindo a expressao: ˜

Vf licker =

1
N

PN
i=3 |l(ti) − 2l(ti−1) + l(ti−2)|
T²
s

, (16)

Em que Ts = 25ms e o per ´ | íodo de amostragem e l é
a iluminaçao medida numa dada lumin ˜ | aria. O resultado ´
desta experiencia encontra-se na secç ˆ | ao V-D. ˜
- Comparaçao do funcionamento com e sem feed- ˜ forward. Para estudar o efeito do termo de feedforward em cada controlador, foram feitas mediçoes da ˜ iluminaçao ao longo do tempo num controlador (com o ˜ outro desligado, porque neste caso apenas se pretendia estudar o efeito do feedforward no seguimento da referencia ˆ
de um no), com e sem termo de ´ | | feedforward. Foram feitas
mediçoes de iluminaç ˜ | ao, em lux, em funç ˜ | ao do tempo, ˜
cujos resultados podem ser visualizados na secçao V-E. ˜
- Comparaçao entre ˜ | additive feedfoward e decoupled
feedforward. Estudou-se a diferença no comportamento de um controlador isolado caso a interaçao entre os ˜ termos feedforward e feedback seja do tipo aditiva ou
decoupled. Foram feitas mediçoes de iluminaç ˜ | ao ao longo ˜
do tempo, presentes na secçao V-F. ˜
- Comparaçao do funcionamento com e sem anti- ˜ windup. De forma analisar o comportamento do sistema com e sem anti-windup, realizou-se uma experiencia em ˆ que o sistema começou com a janela fechada e, de seguida, abriu-se a janela por um período de tempo de cerca de 30 s (para acumular um erro elevado no termo integral). Por ultimo fechou-se a janela para perceber o
tempo que o sistema demorou a regressar a iluminaç ` | aõ
desejada. Foram feitas medidas de iluminaçao numa lu- ˜
minaria, deixando a outra desligada, em funç ´ | ao do tempo. ˜
O limite maximo imposto ao integral foi de ´ | | | | W = 75 lux
Os resultados desta comparaçao est ˜ | ao apresentados na ˜
secçao V-G. ˜
- Resoluçao do problema de controlo distrubu ˜ | | | | ído.
Procedeu-se a alteraç ` | ao do c ˜ | odigo de ´ | Matlab fornecido
(presente no GitHub) para que replicasse as operaçoes ˜ feitas por ambos os controladores e assim analisar as
soluçoes alterando certos par ˜ | ametros. Introduzindo os ˆ
ganhos e as iluminaçoes externas obtidas nos n ˜ | os, foi ´
possível obter as diferentes soluçoes. Os ganhos utiliza- ˜ dos foram: K11 = 0.445, K12 = 0.033, K21 = 0.021
e K22 = 0.333. As iluminaçoes externas e refer ˜ | encias ˆ
dependeram do teste, como se pode ver na secçao V-H. ˜
Os dois ultimos testes envolveram alterar os par ´ | | | | ametros ˆ
da funçao de custo. ˜
- Comparaçao entre controlo cooperativo ou n ˜ | | | | ao co- ˜
operativo. Analisou-se tambem o impacto do controlo ´
entre os dois nos ser cooperativo ou n ´ | ao, isto ˜ | e, se ´
cada um deles funcionava interpretando o outro como uma perturbaçao externa ou se realizavam o algoritmo ˜ de controlo distribuído descrito na secçao III-F. Para isso, ˜ retiraram-se valores de iluminaçao e energia total gasta ˜
em ambas as luminarias, eem funç ´ | ao do tempo, para ˜
ambos os casos, analisados na secçao V-I. ˜
V. RESULTADOS E DISCUSSAÕ
A. Abertura da janela e mudança de referencia ˆ
Analisando os dados presentes na figura 17, ve-se que ˆ
quando a janela e aberta (aproximadamente aos ´ | 4 s), existe
uma diminuiçao do ˜ | duty cycle e um maior flickering na
iluminaçao. Isso ˜ | e devido ´ | a acç ` | ao do termo de ˜ | feedback a
tentar seguir a referencia. Contudo, em termos qualitativos, o ˆ
comportamento foi muito positivo pois a variaçao m ˜ | axima da ´
iluminaçao foi apenas cerca de ˜ | 3% e o tempo de estabeleci-
mento foi menos de 0.5 s (considerando que a abertura da
janela naõ e instant ´ | anea, o que ainda dificulta mais a tarefa do ˆ
controlador pois encontra-se num regime transitorio). Natural- ´ mente, depois desta fase, o duty cycle imposto foi bastante
menor para atingir a referencia, fruto da iluminaç ˆ | ao externa. ˜
Cerca de 10 s mais tarde, alterou-se a ocupaçao da lumin ˜ | aria, ´
o que levou a realizaç ` | ao do algoritmo de controlo distribu ˜ | ído
entre ambos os nos. Ap ´ | os a realizaç ´ | ao do mesmo, o sistema ˜
obteve a iluminaçao esperada praticamente em apenas um ciclo ˜ de sampling (ou seja, sem ter que recorrer ao feedback), o que comprova a qualidade do algoritmo implementado. Em relaçaõ
a sobreelevaç ` | ao, na iluminaç ˜ | ao foi praticamente nula enquanto ˜
no duty cycle foi aproximadamente 5%. Mais tarde, voltou-se a
colocar a ocupaçao dessa ilumin ˜ | aria a 1, e a transiç ´ | ao ocorreu ˜
rapidamente e sem overshooting em qualquer variavel. ´
Um facto importante de salientar e que o ´ | flickering obser-
vado, a maioria e devido a imprecis ´ | oes no ADC do arduino, ou ˜
seja, sao variaç ˜ | oes virtuais no sentido em que o controlador ˜
esta sempre a impor o mesmo ´ | | duty cycle (porque devido à
deadzone o controlador interpreta o desvio como deveria ser,
nulo) so que na convers ´ | ao da tens ˜ | ao aos terminais do LDR ˜
o arduino interpreta como valores ligeiramente distintos. Para corrigir esta imperfeiçao no futuro, o valor de luminosidade ˜ devia ser enviado recorrendo ao erro obtido no PID que, devido
à deadzone implementada, e nulo nestas situaç ´ | oes. ˜

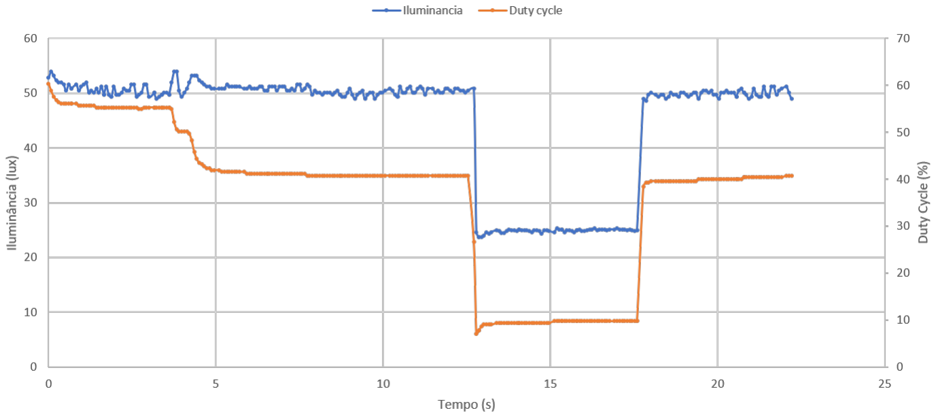
[picture p18: figure]

Figura 17: Abertura da janela e alteraçao de ocupaç ˜ | ao e respetiva ˜
resposta do sistema.
B. Energia gasta pelas luminarias ´
Atraves do gr ´ | afico da figura 18 verifica-se que, apesar dos ´
LED’s estarem ligados durante 40s, eles gastaram menos de 10J. Isto porque o duty cycle de cada LED e ajustado de forma ´
a nao gastar energia desnecess ˜ | aria. O facto de uma ilumin ´ | aria ´
consumir mais energia que a outra deve-se ao facto do controlo
distribuído ajustar, de acordo com varios par ´ | ametros, o duty ˆ
cycle de cada LED da forma mais eficiente.

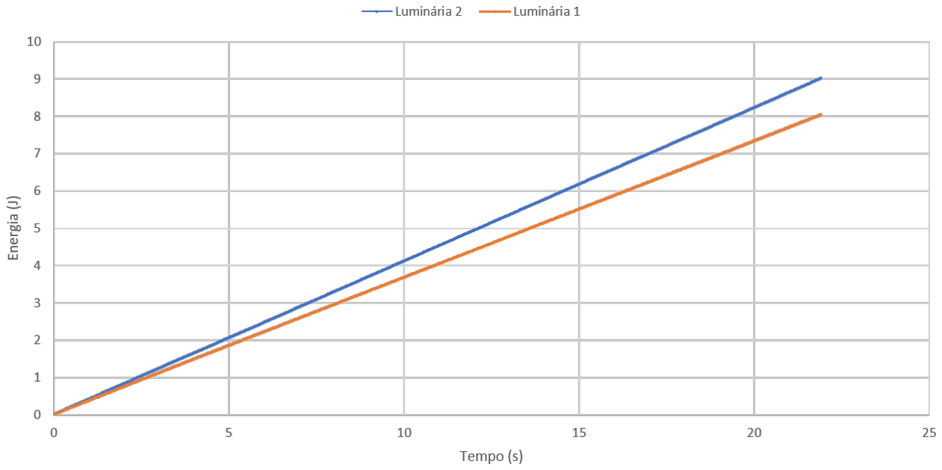
[picture p19: figure]

Figura 18: Energia gasta pelas luminarias em funç ´ | ao do tempo. ˜
C. Erro de conforto
Pode-se verificar que na figura 19 erro e bastante elevado ´ ao inicio, pois a luz ainda esta a convergir para o seu valor ´ de referencia. O erro estabiliza ao fim de 0.5s, sendo que as ˆ luminarias convergem de maneira ligeiramente diferente, pois ´
tem valores de refer ˆ | encia diferentes. ˆ
D. Variancia de conforto ˆ
| Observando o grafico da figura 20, conclui-se que, como ´
no erro de conforto, a variancia varia bastante ao inicio. ˆ
a medida que se atinge o valor de referencia, a vari ` | ancia ˆ

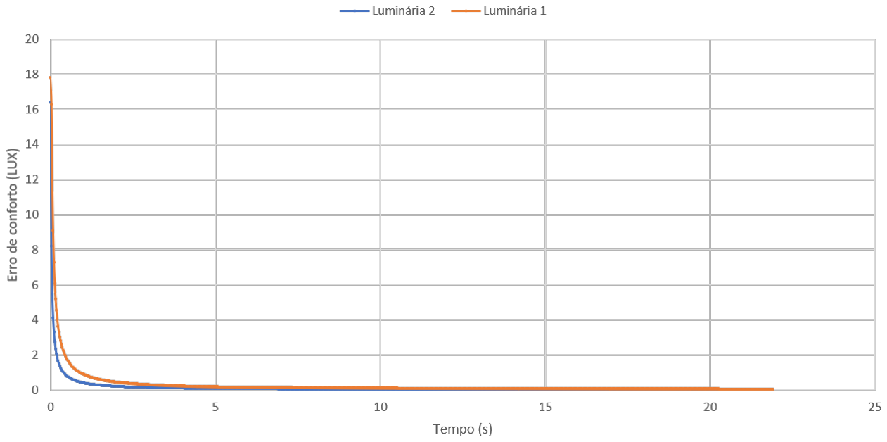
[picture p20: figure]

Figura 19: Erro de conforto das luminarias ao longo do tempo. ´

diminui estabilizando a volta de 40. Este valor engloba o ` flckering devido ao ADC descrito na secçao V-A. Futuramente, ˜
a variancia de conforto tamb ˆ | em devia passar a ser calculada ´
com base no erro do controlador.

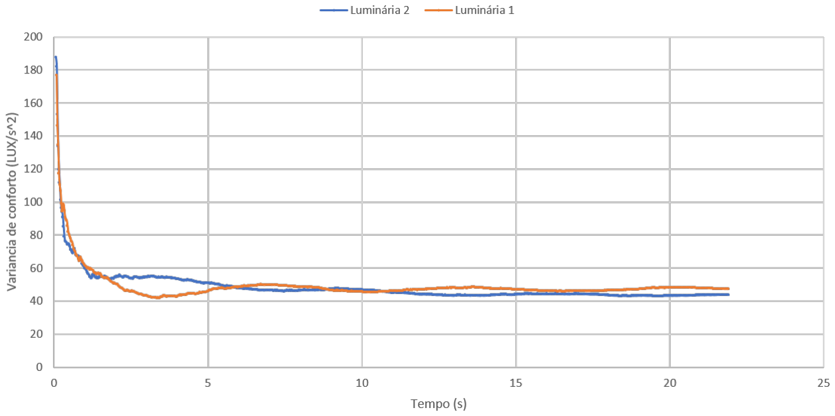
[picture p21: figure]

Figura 20: Variancia de conforto das lumin ˆ | arias ao longo do tempo. ´
E. Comparaçao do funcionamento com e sem feedforward ˜

Como se pode observar da imagem 21, a existencia do ˆ termo de feedforward acelera a resposta do sistema pois impoẽ
logo apos o primeiro ciclo uma estimativa muito pr ´ | oxima ´
do duty cycle que a luminaria ter ´ | a que imp ´ | or. A meio do ˆ
teste alterou-se a referencia HIGH ˆ | →LOW e depois voltou-se
ao estado inicial, e verificou-se que em ambas as alteraçoes ˜ o feedforward acelerou a resposta. Em termos qualitativos, o tempo de estabelecimento sem feedforward era cerca de 0.4 s, enquanto com feedforward era apenas um intervalo de sampling, 0.025 s, muito inferior. Um aspeto negativo pode ser o aumento ligeiro de overshooting nalgumas situaçoes, mas ˜
de qualquer forma e um efeito ainda menor devido ´ | a interaç ` | aõ
entre o feedforward e o feedback do controlador: decoupled feedforward (ver secçao V-F). ˜
F. Comparaçao entre additive feedfoward e decoupled feed- ˜ forward

Analisando os resultados da figura 22 verifica-se que com
uma interaçao simplesmente aditiva, o ˜ | overshoot e muito ´
superior ao caso utilizado (com decoupled feedforward). Concretizando, chegava a valores perto de 20% de overshoot,

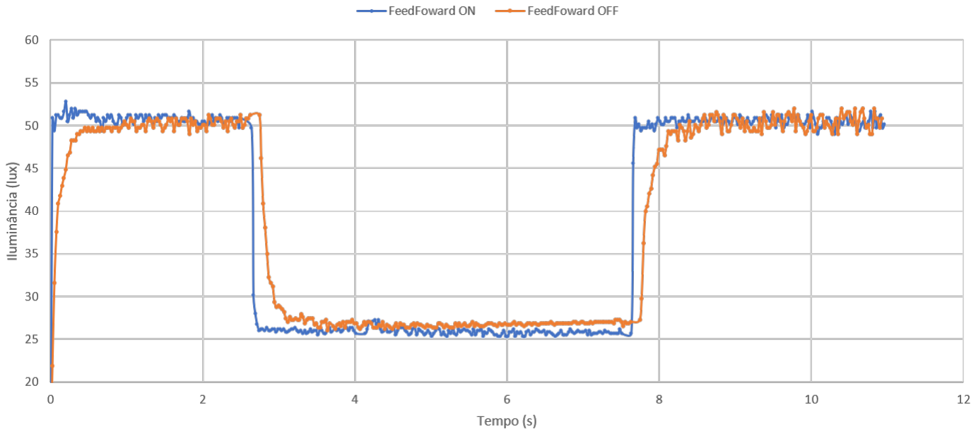
[picture p22: figure]

Figura 21: Comparaçao da iluminaç ˜ | ao ao longo do tempo com e sem ˜
termo de feedforward num unico controlador. ´
contrastanto com a quase inexistencia caso o ˆ | decoupled feed-
forward estivesse ativo. Isso verificou-se tanto nas transiçoes ˜
de referencia HIGH ˆ | →LOW como as inversas.

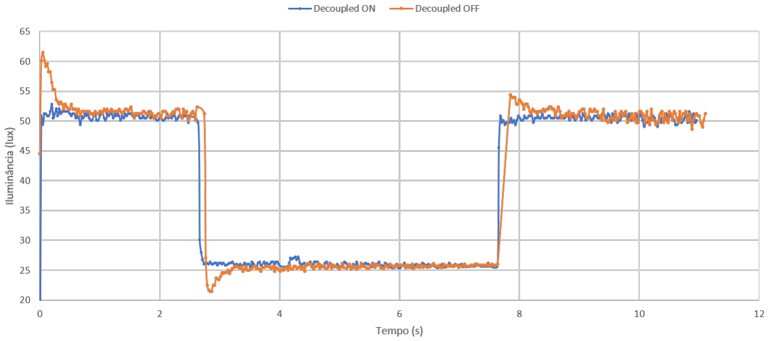
[picture p23: figure]

Figura 22: Comparaçao da iluminaç ˜ | ao ao longo do tempo com e sem ˜
decoupled feedforward, num unico controlador. ´
G. Comparaçao do funcionamento com e sem anti-windup ˜ Ao olhar para a figura 23 verifica-se que o controlador sem
anti-windup demora 20s a regressar a iluminaç ` | ao desejada ˜
apos o fecho da janela, enquanto que, com anti-windup ele ´ tem uma queda acentuada, mas volta quase imediatamente para o valor de referencia. Isto quer dizer que o anti-windup ˆ tem um impacto bastante importante no sistema, pois este impede que o integral tome valores elevados ao ponto de impedir o controlador de colocar a referencia correta. Ou seja, ˆ
o integral tem um limite maximo, possibilitando a recuperaç ´ | aõ
do sistema dentro de um curto de espaço de tempo. Nota-se
que a iluminaçao externa medida para as duas situaç ˜ | oes n ˜ | aõ
foi exatamente igual como se pode ver na figura 23, porque
e imposs ´ | ível recriar igualmente mediçoes de luz externa t ˜ | aõ
intensa como a usada (a luz utilizada foi intensa para garantir que era suficiente para saturar o controlador). Contudo, os resultados aceitam-se na mesma pois a diferença nao foi muito ˜ acentuada.
H. Resoluçao do problema de controlo distribu ˜ | ído
Para os primeiros 3 testes, utilizaram-se custos Ci = 1 para
todos os nos e ´ | qii = 0. Em primeiro lugar, resolveu-se o
problema mais simples: ambos os nos com a mesma refer ´ | encia ˆ
L = 50 lux e com iluminaçoes externas nulas. Os resultados ˜ encontram-se na figura 24. Cada figura mostra as restriçoes ˜
as vari ` | aveis, as curvas de n ´ | ível da funçao de custo, a soluç ˜ | aõ
otima calculada pelo ´ | Matlab e a soluçao ap ˜ | os cada iteraç ´ | aõ
do consensus. Os duty cycle nos dois controladores evoluíram

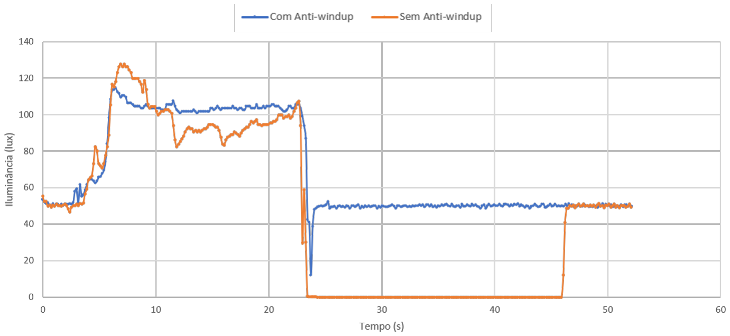
[picture p24: figure]

Figura 23: Comparaçao da iluminaç ˜ | ao ao longo do tempo com e sem ˜
windup.

para valores ligeiramente distintos devido aos ganhos serem
distintos (como os ganhos relativos a lumin ` | aria 2 s ´ | ao mais ˜
baixos, o algoritmo levou a um d2 maior). Procedeu-se entaõ

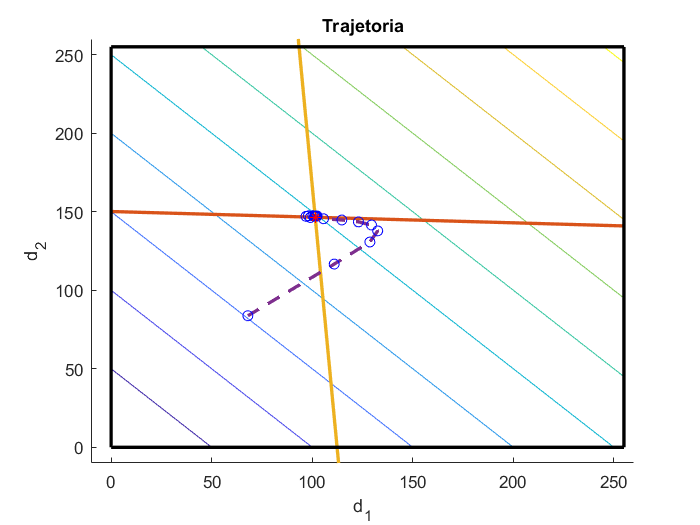
[picture p25: figure]

Figura 24: Soluçao do problema de controlo distribu ˜ | ído com L1 =
50, L2 = 50, o1 = 0, o2 = 0.
a resoluç ` | ao tendo em conta iluminaç ˜ | oes externas: primeiro, ˜
com uma iluminaçao externa que n ˜ | ao fosse acima do m ˜ | ínimo
(25) e de seguida com uma que fosse acima (26). Na primeira, foi definido L1 = 25 lux para ver o impacto de referencias ˆ
distintas. | Como era de esperar, no caso da figura 25 a

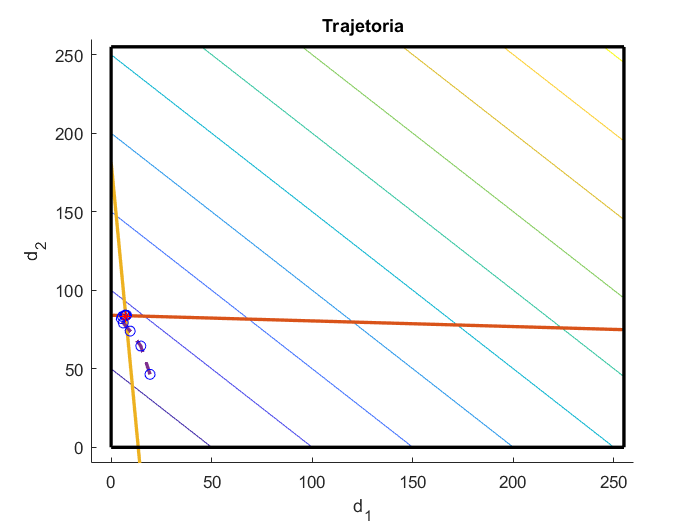
[picture p26: figure]

Figura 25: Soluçao do problema de controlo distribu ˜ | ído com L1 =
25, L2 = 50, o1 = 19, o2 = 22.
luminaria 1 teve que acender pouco pois a iluminaç ´ | ao externa ˜

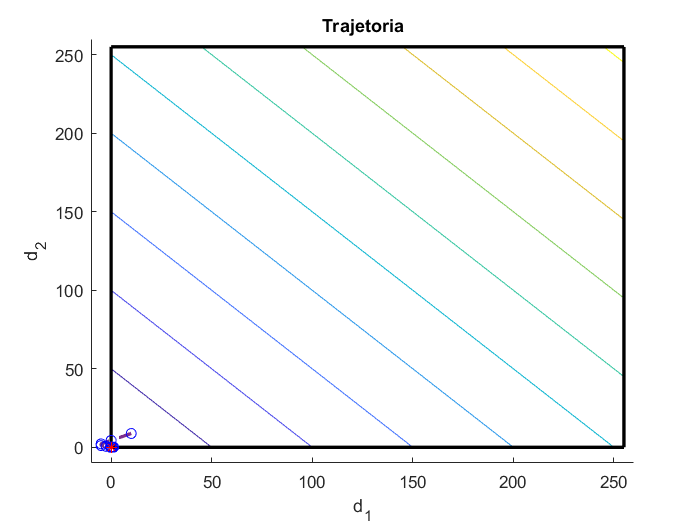
[picture p27: figure]

Figura 26: Soluçao do problema de controlo distribu ˜ | ído com L1 =
50, L2 = 50, o1 = 70, o2 = 70.
era quase igual a sua refer ` | encia m ˆ | ínima, e no caso da figura
26 ambos os duty cycle tenderam para zero pois nao era ˜ necessario acender os LEDs. ´
De seguida, aumentou-se o custo c1 para 4 e encontrouse a soluçao, presente na figura 27. Como se pode ver, esta ˜
alteraçao levou a um aumento do ˜ | duty cycle da luminaria 2 ´
face a lumin ` | aria 1 na soluç ´ | ao final, o que faz sentido pois tinha ˜
um custo menor. Salienta-se a diferença nas curvas de nível, agora com inclinaçao diferente face aos testes anteriores. ˜

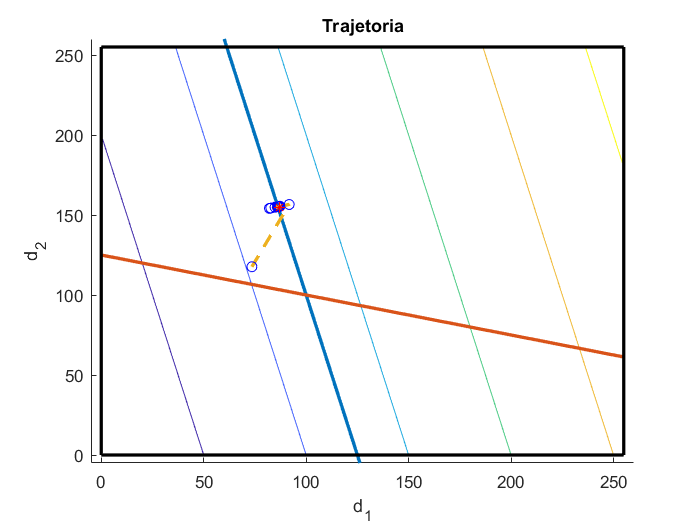
[picture p28: figure]

Figura 27: Soluçao do problema de controlo distribu ˜ | | ído com custos
lineares distintos.
Por ultimo, testou-se a inclus ´ | ao do termo quadr ˜ | atico na ´
funçao de custo, ficando com ˜ | q11 = q22 = 0.1. A soluçaõ
deste caso encontra-se na figura 28. Observou-se que, devido
ao termo quadratico ser baixo, n ´ | ao se verificaram grandes ˜
alteraçoes na soluç ˜ | aõ otima obtida. ´
Para o funcionamento normal do sistema, utilizaram-se c1 = c2 = 1 e q11 = q22 = 0. Futuramente, seria positivo
analisar valores para utilizar no termo quadratico da funç ´ | aõ
de custo. Em relaçao ao n ˜ | umero de iteraç ´ | oes, utilizaram-se ˜
somente 10 iteraçoes dado que era suficiente para o sistema ˜ convergir nas situaçoes testadas, e era importante reduzir o ˜ tempo que os arduinos demoravam a realizar o algoritmo uma vez que crescia exponencialmente com o aumento da rede, caso esta crescesse. Contudo, para uma maior robustez, seria preferível colocar uma condiçao de paragem em vez de um ˜

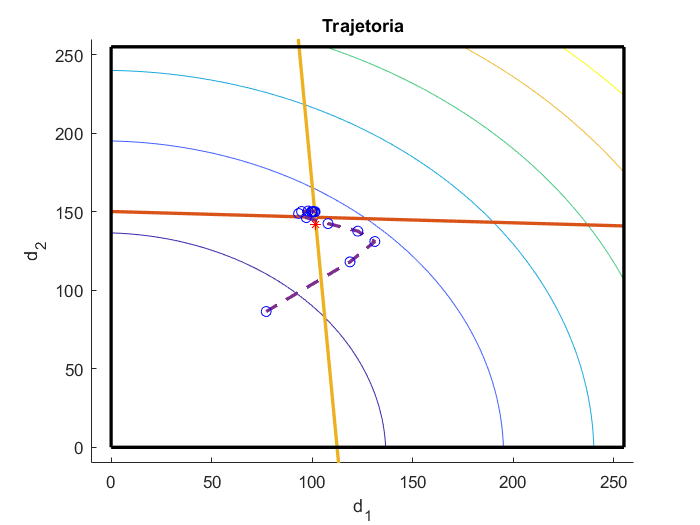
[picture p29: figure]

Figura 28: Soluçao do problema de controlo distribu ˜ | ído com custos
quadraticos. ´
numero de iteraç ´ | oes m ˜ | aximas, como por exemplo, a funç ´ | aõ
de custo diminuir menos de um δ << 1 entre as duas ultimas ´ iteraçoes. ˜
I. Comparaçao entre controlo cooperativo ou n ˜ | ao cooperativo ˜
Como se pode retirar da figura 29, onde estao presentes as ˜ iluminaçoes para um controlador, sem controlo cooperativo, ˜ existe um overshoot de cerca de 8%, enquanto que fazendo o algoritmo de controlo dstribuído e quase inexistente. Isto ´
faz sentido porque caso um no esteja ignorante da exist ´ | encia ˆ
de outros e da sua influencia, ˆ | e natural que coloque mais ´
iluminaçao por si. Contudo, quando a outra lumin ˜ | | | aria acende ´
o seu LED, devido aos efeitos acoplativos, isso vai levar a um
excesso de lux face ao necessario. Embora esta sobreelevaç ´ | aõ
seja rapidamente corrigida pelo termo de feedback do contro-
lador, e not ´ | orio que para o sistema ´ | e prefer ´ | ível um controlo
cooperativo porque alem de anular o ´ | overshooting ainda dimi-
nui o flickering e o tempo de resposta. Alem disso, observando ´

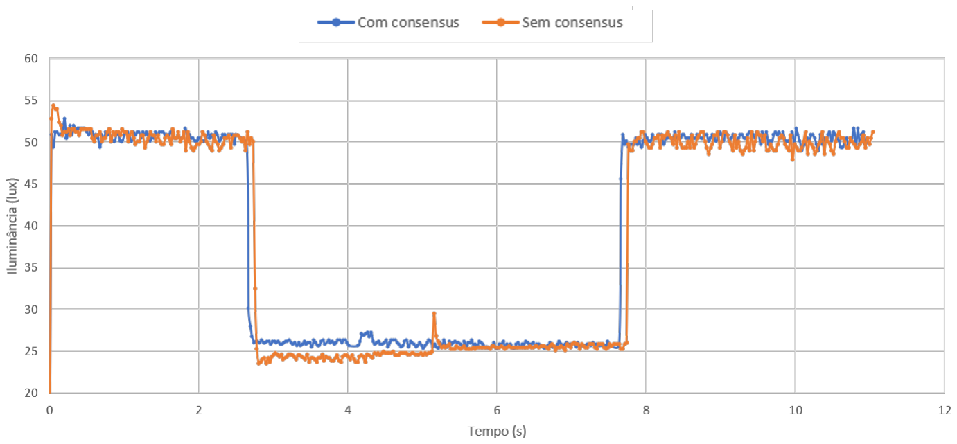
[picture p30: figure]

Figura 29: Comparaçao da iluminaç ˜ | ao ao longo do tempo com e sem ˜
controlo distribuído.

o gasto total de energia para os dois casos presente na figura 30, verificou-se que sem controlo distribuído o sistema gastou mais 1.2J ao fim de 20 segundos. Isto deve-se ao explicado
atras: quando um n ´ | o n ´ ao sabe da exist ˜ | encia do outro, coloca ˆ
iluminaçao a mais, o que se refletiu no consumo maior de ˜ energia.
| VI. CONCLUSOES ˜

Com a implementaçao e estudo do sistema de para controlar ˜
luminarias foi poss ´ | ível verificar que todas as opçoes escolhidas ˜

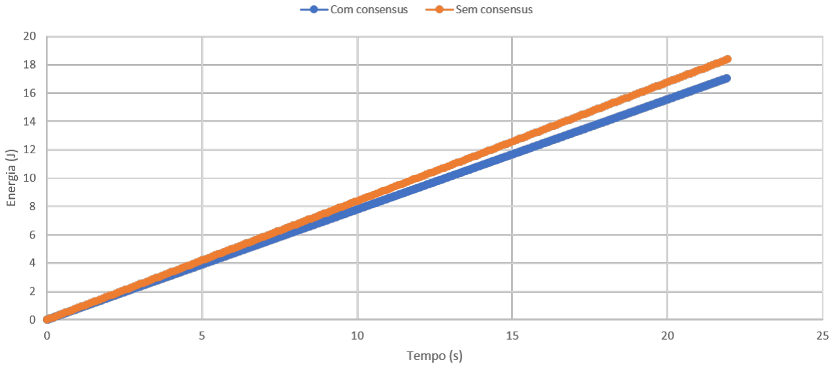
[picture p31: figure]

Figura 30: Comparaçao do consumo de energia total ao longo do ˜ tempo com e sem controlo distribuído.

ao longo da realizaçao do controlador t ˜ | em efeito no sistema e ˆ
no seu desempenho.
Uma das características mais importantes e o controlo ´ distribuído, que tendo em conta uma certa funçao de custo, ˜ escolhe a intensidade de cada lampada da forma mais eficiente ˆ possível. Face ao controlo nao cooperativo, este acaba por ˜ reduzir os gastos de energia e ao mesmo tempo reduz o
overshoot cada vez que ha troca de refer ´ | encia, ou seja, tamb ˆ | em´
leva a um menor flickering.
Para alem do algoritmo de PID b ´ | asico, outras ferramentas ´
foram implementadas de forma a que o sistema reagisse
melhor a mudanças de referencia ou de iluminaç ˆ | ao externa, ˜
como por exemplo o decoupled feedforward e o anti-windup.
Todas estas implementaçoes acabam por ter influ ˜ | encia num ˆ
maior conforto para os utilizadores.
Relativamente ao servidor criado, destaca-se a sua capacidade de armazenar dados uma vez que, de acordo com a sua memoria de 1GB, estimou-se que era capaz de guardar a ´ informaçao vinda do arduino durante cerca de 180 horas, ou ˜ seja, cerca de uma semana.
Contudo, varios aspetos do sistema ainda podem ser ´ aperfeiçoados. Nomeadamente, as comunicaçoes por I2C para ˜ fornecer informaçao do sistema ao Raspberry Pi podiam ser ˜ aceleradas retirando todas os caracteres auxiliares para leitura e armazenamento pela funçao de ˜ sniff. Caso o sistema fosse constituído por um numero muito grande de arduinos, todas ´
estas comunicaçoes podiam ultrapassar a frequ ˜ | encia de amos- ˆ
tragem. Outro aspeto a melhorar seria criar uma thread apenas para o stream para diminuir o tempo maximo de resposta aos ´ clientes.

VII. CONTRIBUIÇ OES ˜

A. Projeto
Carlos Aleluia, 81038:
- Algoritmo de PID e respetivas funcionalidades;
- Calibraçao do sistema conjunto; ˜
- Algoritmo do Consensus;
- Comunicaçoes Arduino-Arduino (I2C); ˜
- Comunicaçoes Raspberry Pi-Arduino (Serial) - receç ˜ | | aõ
no arduino.
Filipe Madeira, 81076:
- Identificaçao do sistema; ˜
- Algoritmo de PID e respetivas funcionalidades;
- Comunicaçoes Raspberry Pi-Arduino (Serial) - receç ˜ | | aõ
no arduino;

- Armazenamento de dados no Raspberry Pi (classe Data);
- Stream.
Mariana Martins, 80856:
- Algoritmo de PID e respetivas funcionalidades;
- Servidor
- Sniff e FIFO;
- Comunicaçoes Raspberry Pi-Arduino (Serial) - envio pelo ˜ Raspberry Pi;
- Stream.
Nota-se que, embora cada aluno tenha areas onde tenha ´ contribuído mais do que noutras, a maioria do trabalho foi feita na presença de todos os elementos do grupo pelo que todos estao familiarizados com o projeto inteiro. ˜
B. Relatorio ´

Carlos Aleluia, 81038:
- Calibraçao do sistema; ˜
- Controlo Distribuído e Otimizaçao; ˜
- Comunicaçao I2C; ˜
- Experiencias; ˆ
- Resultados;
- Conclusoes. ˜
Filipe Madeira, 81076:
- Configuraçao do sistema; ˜
- Calibraçao do LDR; ˜
- Identificaçao do sistema; ˜
- Controlador;
- Resultados;
- Conclusoes. ˜
Mariana Martins, 80856:
- Abstract;
- Introduçao; ˜
- Arquitetura de software do Arduino;
- Arquitetura de software do Raspberry Pi;
- Ediçao do v ˜ | ídeo;
- Conclusoes. ˜

REFERENCIAS ˆ

[1] Diffen: Incandescent Bulbs vs. LED Bulbs
https://www.diffen.com/difference/Incandescent_Bulbs_vs_LED_Bulbs. Acedido a 30 de Dezembro de 2017.
[2] Diffen: CFL vs. LED Bulbs
https://www.diffen.com/difference/Fluorescent_Bulbs_vs_LED_Bulbs. Acedido a 30 de Dezembro de 2017.
[3] D. Caicedo, A. Pandharipande Distributed Illumination Control With
Local Sensing and Actuation in Networked Lighting Systems. (https://fenix.tecnico.ulisboa.pt/downloadFile/3779579952577/DistributedIlluminationControlWithLocalSensing.pdf) IEEE
Sensors Journal, Vol. 13, No 3, Março 2013.
[4] D. Caicedo, A. Pandharipande Daylight integrated illumination control of LED systems based on enhanced presence sensing. (https://fenix.tecnico.ulisboa.pt/downloadFile/3779579952576/1-s2.0-S0378778810004597-main.pdf) Energy and Buildings 43 (2011) 944–950, 2010.
[5] C. Fernandez, D.R. Distributed smart lighting systems : sensing and control. (https://pure.tue.nl/ws/files/3799294/774336.pdf) Technische Universiteit Eindhoven DOI: 10.6100/IR774336, 2014.
[6] A. Bernardino. Solution of Distributed Optimization Problems: The consensus algorithm. (https://fenix.tecnico.ulisboa.pt/downloadFile/1689468335597775/consensus.pdf) 2017
[7] Stephen Boyd, Neal Parikh, Eric Chu, Borja Peleato e Jonathan Eckstein. Distributed Optimization and Statistical Learning via the Alternating Direction Method of Multipliers.. (https://web.stanford.edu/~boyd/papers/pdf/admm_distr_stats.pdf) 2010
[8] Arduino Playground - MatrixMath.
http://playground.arduino.cc/Code/MatrixMath. Acedido a 30 de Dezembro de 2017.
[9] J. Valdez, J. Becker.
Understanding the I2C Bus. (http://www.ti.com/lit/an/slva704/slva704.pdf) 2015
[10] BOOST C++ Libraries.
http://www.boost.org/.
Acedido a 30 de Dezembro de 2017.
[11] pigpio library Examples.
http://abyz.me.uk/rpi/pigpio/examples.html. Acedido a 30 de Dezembro de 2017.
