Mrrvm/SCDTR/papers/consensus.pdf

# Real-Time Distributed Control Systems 2017/18 Chapter 18 Solution of Distributed Optimization Problems: The consensus algorithm

Alexandre Bernardino

November 17, 2017

## 1 The global optimization problem

Our overal cost to optimize is:

d

∗ = argmin

d∈C
1
2

d

T Qd + c

T d

with:
d =
d1 | · · · | dN

T

c =

c1 | · · · | cN

T

Q =

q1 | 0 | · · · | 0
0 | q2 | · · · | 0
0 | 0 | · · · | qN

T

and the constraints:

C :

0 ≤ di ≤ 100 and X N

j=1

kijdj ≥ Li − oi

, ∀i

## 2 The consensus algorithm

The consensus algorithm distributes the computation over a set of nodes in a network (see [1] for the details). Each node i holds a local copy di of the global variable d.
di =

di1 | · · · | dii | · · · | diN T

1

The cost function and the constraints of each node are partitions of the global cost function. Then it uses a method called ADMM (alternated direction method of multipliers) with the constraints that all local copies di should be identical (thus identical to their average). ADMM uses an augmented Lagrangian method (augments the Lagrangian with a quadratic term to promote the convergence of the method) to iterate the computation of the local solutions and the Lagrange multipliers. At each node i we have the following iterations in time t:

di(t + 1) = argmin

di∈Ci

1
2 + c

T
i di + y

T
i

(t)(di − d¯
i(t)) + ρ
2

kdi − d¯
i(t)k

2
2
d¯

i(t + 1) = PN
j=1 dj (t)
yi(t + 1) = yi(t) + ρ

di(t + 1) − d¯
i(t + 1)

where yi are Lagrange multipliers, ρ is the augmented Lagrangian method penalty parameter, and d¯
i

is the average of the solutions of the nodes. The parameters of the local cost function only consider the effect of the current node:
ci =
0 · · · | ci
- · · | 0

T

Qi = diag(0, · · · , 0, qi

, 0, · · · , 0) =

0 | 0
qi
0 | 0

T

The local constraint also only considers a reduced number of constraints (in our case the ones that constrain the illuminance level at the node’s desk), so that each local problem is easy to solve:

Ci
:
0 ≤ di ≤ 100 and k

T
i di ≥ Li − oi

with
ki =

ki1 | · · · | kii | · · · | kiN T

## 3 The Primal Iterates

To solve the problem we have to iterate the computation of the primal variables di

, the computation of the average of the primal variables of all nodes, and the dual variables yi

. The hard problem is the first one. Let us see how to solve it. The primal iteration is:

di(t + 1) = argmin

di∈Ci

1
2

d

T
i Qidi + c
| T
i di + y

T
i

(t)(di − d¯

i(t)) + ρ
2

kdi − d¯
i(t)k

2/2

It can be written as:

di(t+1) = argmin

di∈Ci

1
2

d

T
i Qidi + d

T
i ci + d

T

i yi(t) − d¯T
i

(t)yi(t) + ρ
2

(di − d¯(t))T

(di − d¯(t))

2

Because we are minimizing in di we can remove from the cost all terms that do not depend in di

di(t+1) = argmin

di∈Ci

1
2

d

T
i Qidi + d

T
i ci + d

T

i yi(t) + ρ
2

d

T
i di − ρd

T

i d¯

i(t) + ρ
2

d¯T
i

(t)d¯
i(t)

Now, collecting terms, we have:

di(t + 1) = argmin

di∈Ci

1
2

d

T
i

(Qi + ρI) di + d

T
i

ci + yi(t) − ρd¯
i(t)

where

Ri = Qi + ρI = diag(ρ, · · · , ρ, ρ + qi

, ρ, · · · , ρ) =

ρ | 0
ρ + qi
0 | ρ

and
zi(t) = −ci + −yi(t) + ρd¯ i(t)

Finally:

di(t + 1) = argmin

di∈Ci

1
2

d

T
i Ridi − d

T
i zi(t)

Let:
f

t

(di) = 1
2

d

T
i Ridi − d

T
i zi(t)

This is an optimization problem with a convex function f

t
| (di) and convex set
Ci
. The solution is in the interior of the feasible region or at its boundary.

## 4 Solution in the interior

Because our cost function is a convex quadratic form, if the solution is in the interior of the set, then it is the global solution. To compute the global solution we solve for ∇f

t
(di) = 0:

∇f

t
(di) = Ridi − zi(t) = 0

Thus we get:
d

0
i

(t + 1) = R

−1
i

zi(t)

where the superscript 0 indicates this is the global unconstrained solution, and:

Pi = R

−1

i = diag
1
ρ

, · · · ,

1
ρ

,

1
ρ + qi

,

1
ρ

, · · · ,

1
ρ
=

1
ρ

0

1
ρ+qi
0

1
ρ

3

Finally, we can write:

d

0
i

(t + 1) = Pizi(t) =

zi1(t)
ρ

zii(t)
ρ+qi

ziN (t)
ρ

=

ρd¯i1(t)−yi1(t)
ρ
ρd¯ii(t)−yii(t)−ci
ρ+qi
ρd¯iN (t)−yiN (t)
ρ

In summary, the variables of the solution that are not controlled directly by the node are computed as:

d

0

ij (t + 1) = ¯dj (t) − yij (t)/ρ, j 6= i

The variable that is controlled by the node itself is given by:

d

0

ii(t + 1) = 1
ρ + qi

(ρ

¯di(t) − yii(t) − ci)

Now we must check for feasibility. The feasibility set is an affine inequality:

Ci

: {Cidi ≤ bi}

with

Ci =

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
where
e

T
i =
0 · · · | 1 · · · | 0

and

bi =

oi − Li
| 0
| 100

If the unconstrained minimum is not feasible, we have to look for the solutions on the boundary.

## 5 Solutions in the boundary

To look for the solutions on the boundary, we must solve the following optimization problem:

di(t + 1) = argmin
di∈∂Ci
1
2
| d T
i Ridi − d

T
i zi(t)

How to characterize the boundary ∂Ci of the feasible region Ci ?

Ci

: {Cidi ≤ bi}

Our feasible region is bounded by three constraints:

4

CT1 The linear constraint on the minimum illuminance of the desk

kido = Li − oi

CT2 The lower bound on the luminaire intensity (0)

dii = 0

CT3 The upper bound on the luminaire intensity (100)

dii = 100

So, the boundary of the feasible region is composed of the boundaries of the individual constraints CT1, CT2 and CT3 (hyperplanes of dimension N − 1 -lines in a 2D problem) and the boundaries of the intersection of constraints CT1 with CT2, and CT1 with CT3 (hyperplanes of dimension N − 2 - points in a 2D problem). Note that CT2 and CT3 are impossible to hold at the same time. Mathematically the boundary of Ci can then be defined by the union of these five sets intersected with the feasible region:

∂Ci =

[

5

j=1

S

j
i ∩ Ci

where
S

j
i

:

n
A

j
idi = u

j
i

o

with
A

1
i = −k

T
i

, u

1
i = oi − Li

A

2
i = −e

T
i

, u

2
i = 0

A

3
i = e

T
i

, u

3
i = 100

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
oi − Li
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
oi − Li

100

The strategy to find the solution is to compute the optimum d

j
i

of the cost
function subject to each of the sets S

j
i

, then check if the solution is feasible Cid

j
i ≤ bi
, and finally select the coordinate of minimum of the feasible optima d

j
i

5

### 5.1 Solution general form

Let us consider the general form of the solution to the problem:

di(t + 1) = argmin

di

1
2

d

T
i Ridi − d

T
i

zi(t)

s.t.
Aidi = ui

Let us form the Lagrangian:

L(di

, λ) = 1
2

d

T
i Ridi − d

T
i zi(t) + λ

T (Aidi − ui)

The solution is obtained at a stationary point of the Lagrangian restricted to the constraint:
∇L = 0
Aidi = ui

Ridi − zi(t) + AT
i λ = 0
Aidi = ui

Ri AT
i
Ai 0

di
λ
=
zi(t)
ui
di
λ
=

Ri AT
i
Ai 0

−1
zi(t)
ui

To compute the matrix inverse in the previous equation let us use the following lemma:
A | B
BT | D

−1
=

A⁻¹ + A⁻¹B(D − BT A⁻¹B)

−1BT A⁻¹ A⁻¹B(D − BT A⁻¹B)

−1
(D − BT A⁻¹B)

−1BT A⁻¹

(D − BT A⁻¹B)

−1

Replacing A by Ri

, B by AT
i

, D by 0, and recalling that Pi = R

−1
i

, we have:

Ri AT
i
Ai 0

−1
=

Pi − PiAT
i

(AiPiAT
i

)

−1AiPi PiAT
i

(AiPiAT
i

)

−1
(AiPiAT
i

)

−1AiPi | −(AiPiAT
i

)

−1

Thus, d

∗
i

can be computed by:

d

∗
i

(t + 1) = Pizi(t) − PiA

T
i

(AiPiA

T
i

)

−1AiPizi(t) + PiA
T
i

(AiPiA

T
i

)

−1ui

Let:
Xi = AiPiA

T
i
wi(t) = AiPizi(t)

Then we have the slightly simpler form:

d

∗
i

(t + 1) = Pizi(t) + PiA

T
i X

−1
i

(ui − wi(t))

6

### 5.2 Solution in S

1
i
A

1
i = −k

T
i

, u

1
i = oi − Li

A

1
i Pi =

h
−

ki1
ρ
- · · −

kii
ρ+qi
- · · −

kiN
ρ

i

w¹
i
(t) = −

ki1
ρ

zi1(t) − · · · −

kii
ρ + qi

zii(t) − · · · −

kiN
ρ

ziN (t)

X¹
i =

k

2
i1
ρ

+ · · · +

k

2
ii
ρ + qi

+ · · · +

k

2
iN
ρ
The right hand side of the previous equation is the squared Pi norm of ki .
Let us denote it by ni

:

ni = kkik

2
Pi =

k

2
i1
ρ

+ · · · +

k

2
ii
ρ + qi

+ · · · +

k

2
iN
ρ

Thus
(X¹
i

)

−1 =

1
n1
Finally:

d

1
i

(t+1) =

zi1(t)
ρ

zii(t)
ρ+qi

ziN (t)
ρ

−

1
ni

ki1
ρ

kii
ρ+qi

kiN
ρ

(oi−Li+

ki1
ρ

zi1(t)+· · ·+

kii
ρ + qi

zii(t)+· · ·+

kiN
ρ

ziN (t))

### 5.3 Solution in S

2
i
A

2
i = −e

T
i

, u

2
i = 0

A

2
i Pi =
0 · · · −

1
ρ+qi
- · · 0

w²
i
(t) = −

zii(t)
ρ + qi

X²
i =

1
ρ + qi

(X²
i

)

−1 = ρ + qi

7

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

(X⁴
i

)

−1 =

1

ni
ρ+qi

−

k

2
ii
(ρ+qi)

2

"
1
ρ+qi

−kii
ρ+qi
−kii
ρ+qi

ni

(X⁴
i

)

−1 =

(ρ + qi)

2
ni(ρ + qi) − k

2

ii "
1
ρ+qi

−kii
ρ+qi
−kii
ρ+qi

ni

(X⁴
i

)

−1 =

ρ + qi
ni(ρ + qi) − k

2
ii
1 | −kii
−kii | ni(ρ + qi)

Let:
gi =

ρ + qi
ni(ρ + qi) − k

2
ii

Pi(A

4
i

)

T

(X⁴
i

)

−1 = gi

−

ki1
ρ

ki1kii
ρ
0

k

2
ii
ρ+q1

− ni
−

kiN
ρ

kiN kii
ρ

Recall that:

ni =

k

2
i1
ρ

+ · · · +

k

2
ii
ρ + qi

+ · · · +

k

2
iN
ρ
Let:
k

r
i =

ki1 | · · · | 0 · · · | kiN T

We can write:

Pi(A

4
i

)

T

(X⁴
i

)

−1 =

gi
ρ

−ki1 | ki1kii
0 | −kk r i
k
| 2
| 2
−kiN | kiN kii

Pi(A

4
i

)

T

(X⁴
i

)

−1w⁴
i
(t) = gi
ρ

ki1ki1zi1(t)
ρ + · · · +

ki1kiizii(t)
ρ+qi

+ · · · +

ki1kiN ziN (t)
ρ | −

ki1kiizii(t)
ρ
−

kk

r
i k

2/2 zii(t)
ρ+qi

kiN ki1zi1(t)
ρ + · · · +

kiN kiizii(t)
ρ+qi

+ · · · +

kiN kiN ziN (t)
ρ | −

kiN kiizii(t)
ρ

Let:
vi(t) = z

T
i

(t)k

r
i

9

We can write:

Pi(A

4
i

)

T

(X⁴
i

)

−1w⁴
i
(t) = gi
ρ

ki1
ρ

vi(t)
−

kk

r
i k

2
2
ρ+qi

zii(t)

kiN
ρ

vi(t)

Pi(A

4
i

)

T

(X⁴
i

)

−1ui(t) = gi
ρ

−ki1(oi − Li)
0

−kiN (oi − Li)

Finally:

d

4
i

(t + 1) =

zi1(t)
ρ

zii(t)
ρ+qi

ziN (t)
ρ

+

gi
ρ

ki1(Li − oi) −

ki1
ρ

vi(t)
kk

r
i k

2
2
ρ+qi

zii(t)

kiN (Li − oi) −

kiN
ρ

vi(t)

### 5.6 Solution in S

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
oi − Li

100

A

5
i Pi =

"
−

ki1
ρ
- · · −

kii
ρ+qi
- · · −

kiN
ρ
0 · · ·

1
ρ+qi
- · · 0

w⁵
i
(t) = "
−

ki1
ρ

zi1(t) − · · · −

kii
ρ+qi

zii(t) − · · · −

kiN
ρ

ziN (t)

zii(t)
ρ+qi

X⁵
i =

"
ni −

kii
ρ+qi
−

kii
ρ+qi

1
| ρ+qi

(X⁵
i

)

−1 =

1

ni
ρ+qi

−

k

2
ii
(ρ+qi)

2

"
1
ρ+qi

kii
ρ+qi
kii
ρ+qi

ni

(X⁵
i

)

−1 =

(ρ + qi)

2
ni(ρ + qi) − k

2

ii "
1
ρ+qi

kii
ρ+qi
kii
ρ+qi

ni

10

(X⁵
i

)

−1 =

ρ + qi
ni(ρ + qi) − k

2
ii
1 | kii
kii | ni(ρ + qi)

Let:
gi =

ρ + qi
ni(ρ + qi) − k

2
ii

Pi(A

5
i

)

T

(X⁵
i

)

−1 = gi

−

ki1

| | ρ | − ki1kii
| | | ρ
| | 0 | − k
| | | 2
| | | ii
| | | ρ+q1 + ni
| | − kiN
| | ρ | − kiN kii
| | | ρ

Recall that:

ni =

k

2
i1
ρ

+ · · · +

| | k
| | 2
| | ii
| | ρ + qi

+ · · · +

| | | k
| | | 2
| | | iN
| | | ρ
Let:
k

r
i =

ki1 | · · · | 0 · · · | kiN T

We can write:

Pi(A

5
i

)

T

(X⁵
i

)

−1 =

gi
ρ

−ki1 | −ki1kii
0 | kk r i
k
| 2
| 2
−kiN | −kiN kii

Pi(A

5
i

)

T

(X⁵
i

)

−1w⁵
i
(t) = gi
ρ

ki1ki1zi1(t)
ρ + · · · +

ki1kiizii(t)
ρ+qi

+ · · · +

ki1kiN ziN (t)
ρ | −

ki1kiizii(t)
ρ
kk

r
i k

2/2 zii(t)
ρ+qi

kiN ki1zi1(t)
ρ + · · · +

kiN kiizii(t)
ρ+qi

+ · · · +

kiN kiN ziN (t)
ρ | −

kiN kiizii(t)
ρ

Let:
vi(t) = z

T
i

(t)k

r
i
We can write:

Pi(A

5
i

)

T

(X⁵
i

)

−1w⁵
i
(t) = gi
ρ

ki1
ρ

vi(t)
kk

r
i k

2
2
ρ+qi

zii(t)

kiN
ρ

vi(t)

11

Pi(A

5
i

)

T

(X⁵
i

)

−1ui(t) = gi
ρ

−ki1(oi − Li) − 100ki1kii
100kk

r
i

k

2
2
−kiN (oi − Li) − 100kiN kii

Finally:

d

5
i

(t + 1) =

zi1(t)
ρ

zii(t)
ρ+qi

ziN (t)
ρ

+

gi
ρ

ki1(Li − oi) − 100ki1kii −

ki1
ρ

vi(t)
100kk

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
ρ+qi

zii(t)

kiN (Li − oi) − 100kiN kii −

kiN
ρ

vi(t)

## References

[1] Stephen Boyd, Neal Parikh, Eric Chu, Borja Peleato and Jonathan Eckstein. Distributed Optimization and Statistical Learning via the Alternating Direction Method of Multipliers. Foundations and Trends in Machine Learning, Vol. 3, No. 1 (2010) 1122.

12
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
