Mrrvm/SCDTR/papers/Experiencias.xlsx

Sheet: Feedfoward ON e OF
FeedFoward ON |  | FeedFoward OF
17502 | 53.18 | 17378 | 9.98
17527 | 50.84 | 17403 | 21.9
17553 | 49.35 | 17429 | 31.59
17579 | 51.22 | 17455 | 37.54
17603 | 51.22 | 17479 | 40.86
17628 | 50.84 | 17504 | 41.75
17653 | 50.84 | 17528 | 42.96
17679 | 51.6 | 17553 | 43.9
17704 | 52.78 | 17579 | 44.87
17728 | 50.46 | 17604 | 46.53
17753 | 51.22 | 17630 | 46.87
17778 | 51.99 | 17655 | 48.27
17804 | 50.84 | 17680 | 48.27
17829 | 51.99 | 17704 | 48.27
17855 | 51.22 | 17728 | 48.99
17880 | 51.6 | 17753 | 48.99
17904 | 51.6 | 17778 | 49.35
17929 | 51.6 | 17804 | 49.35
17954 | 51.6 | 17829 | 49.72
17980 | 51.6 | 17854 | 49.35
18004 | 51.22 | 17879 | 49.72
18028 | 50.84 | 17903 | 49.35
18053 | 51.22 | 17928 | 49.72
18078 | 51.22 | 17953 | 49.35
18104 | 50.46 | 17979 | 49.35
18129 | 50.84 | 18004 | 49.72
18154 | 50.46 | 18029 | 49.35
18179 | 49.35 | 18055 | 49.72
18204 | 50.84 | 18079 | 49.35
18230 | 50.46 | 18104 | 49.72
18255 | 51.22 | 18128 | 49.72
18280 | 50.84 | 18153 | 49.72
18305 | 51.22 | 18179 | 49.35
18329 | 50.46 | 18204 | 49.72
18354 | 50.09 | 18230 | 49.72
18379 | 50.09 | 18255 | 49.72
18405 | 51.22 | 18280 | 49.35
18430 | 50.84 | 18305 | 49.72
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
