Mrrvm/SCDTR/papers/Excel_SCDTR.xlsx

Sheet: Folha1
0 | 1,00393700787402 | 2,00787401574803 | 3,01181102362205 | 4,01574803149606 | 5,01968503937008 | 6,02362204724409 | 7,02755905511811 | 8,03149606299213 | 9,03543307086614 | 10,0393700787402 | 11,0433070866142 | 12,0472440944882 | 13,0511811023622 | 14,0551181102362 | 15,0590551181102 | 16,0629921259843 | 17,0669291338583 | 18,0708661417323 | 19,0748031496063 | 20,0787401574803 | 21,0826771653543 | 22,0866141732283 | 23,0905511811024 | 24,0944881889764 | 25,0984251968504 | 26,1023622047244 | 27,1062992125984 | 28,1102362204724 | 29,1141732283465 | 30,1181102362205 | 31,1220472440945 | 32,1259842519685 | 33,1299212598425 | 34,1338582677165 | 35,1377952755906 | 36,1417322834646 | 37,1456692913386 | 38,1496062992126 | 39,1535433070866 | 40,1574803149606 | 41,1614173228346 | 42,1653543307087 | 43,1692913385827 | 44,1732283464567 | 45,1771653543307 | 46,1811023622047 | 47,1850393700787 | 48,1889763779528 | 49,1929133858268 | 50,1968503937008 | 51,2007874015748 | 52,2047244094488 | 53,2086614173228 | 54,2125984251969
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
