Mrrvm/SCDTR/papers/Lux(R)andT(Lux).jpg

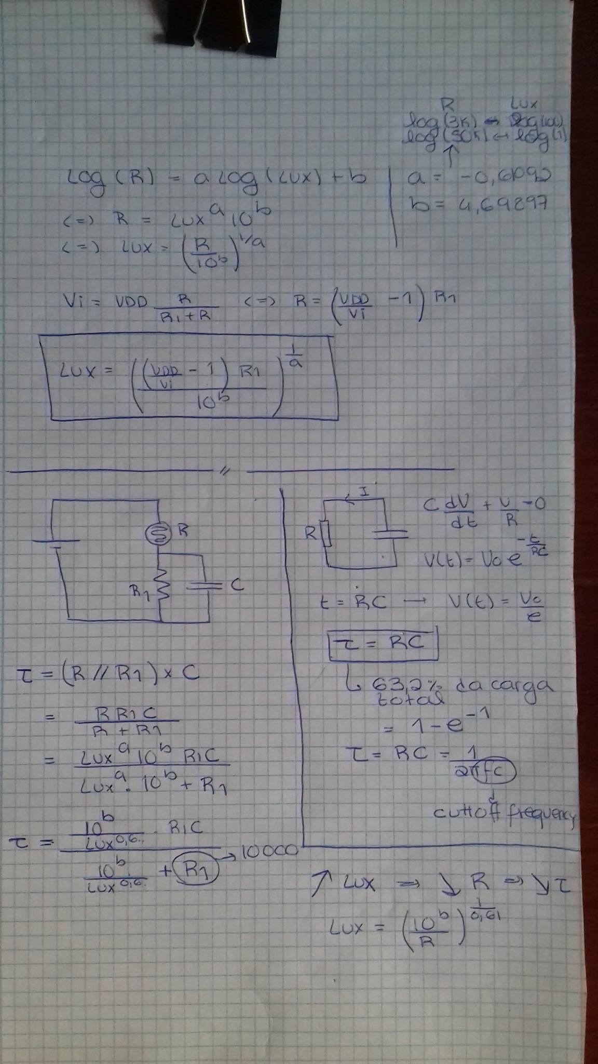
papers/Lux(R)andT(Lux).jpg
