Mrrvm/SCDTR/papers/T(Lux).bmp

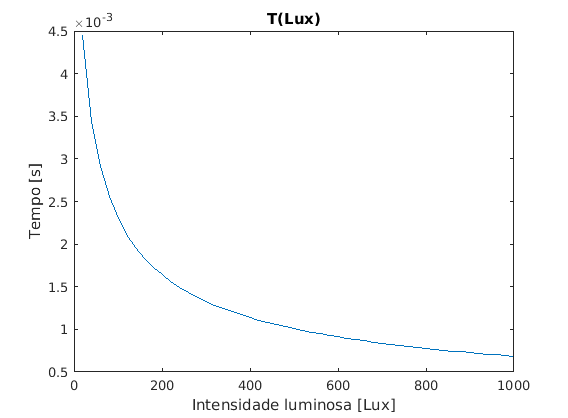
papers/T(Lux).bmp
