Mrrvm/SCDTR/(commit log)

2017-10-09 Projeto Arduino
2017-10-19 class PID
2017-10-19 Added pid arduino code
2017-10-21 Upgrade PID class
2017-10-23 Formatted pid.ino
2017-10-26 Arduino_PID
    quase completo xD
    [Excel_SCDTR.xlsx]
2017-10-29 Added new version of pid
2017-11-09 Divided PID.ino into files
2017-11-28 consensus for arduino is working
    [Excel_SCDTR.xlsx]
2017-12-01 Studying server
    [Excel_SCDTR.xlsx]
2017-12-13 Serial thread is done!
2017-12-16 1.0.0.1
    Tem as respostas para ao arduino e falta fazer as contas
2017-12-17 novo arduino code
2017-12-18 working sem motor
2018-01-07 Excel com experiencias
    [Experiencias.xlsx]
2018-01-08 Experiencias ja com C_error, a variancia e a energia
    [Experiencias.xlsx]
2018-01-08 Experiencias todas feitas
    [Experiencias.xlsx]
2018-01-10 energia sem consensus
    [Experiencias.xlsx]
2018-01-10 cleaned up a bit
    [Experiencias.xlsx]
2018-01-11 Changed dir
    [Experiencias.xlsx]
2018-01-11 mv dir
    [Experiencias.xlsx]
